jamwaffles/CNCMachine/IndramatResolver/PCB/20200531_093949688_iOS.jpg

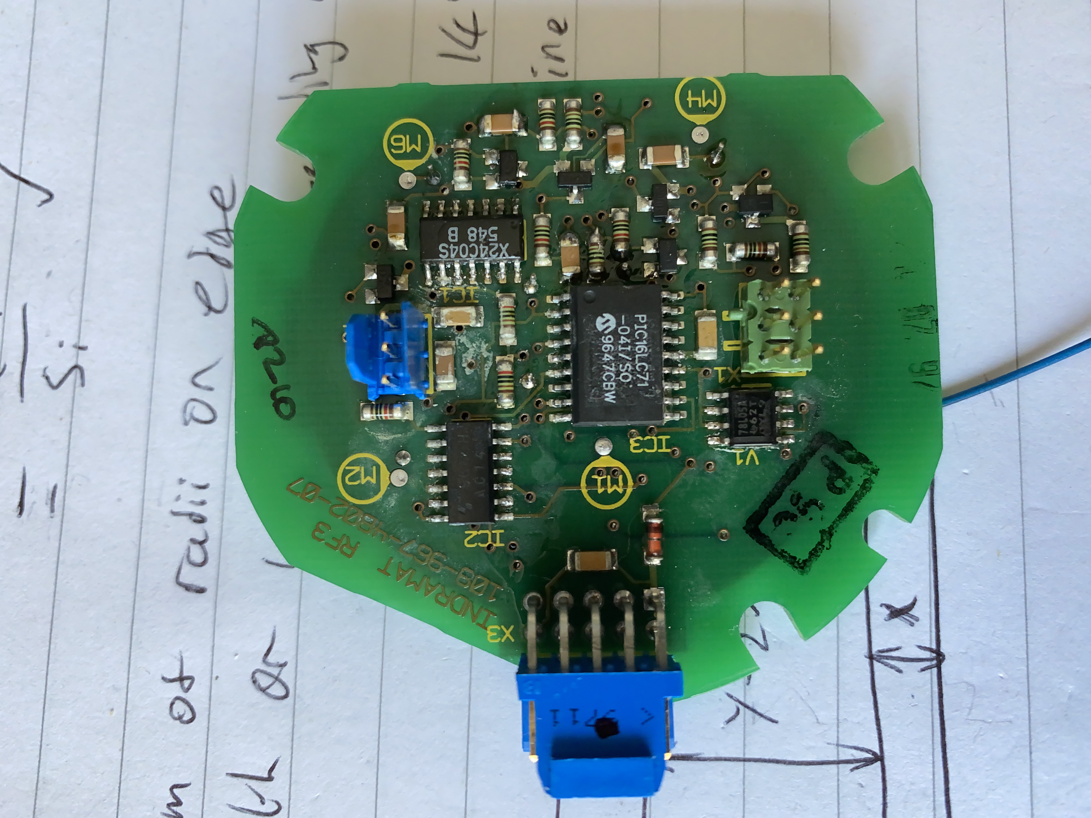
IndramatResolver/PCB/20200531_093949688_iOS.jpg
