jamwaffles/CNCMachine/tool-data/5mm Diameter Variable Helix Carbide End Mill for Aluminium DLC Coated 13mm Flute Associated Production Tools_files/EAV3S-3-FLUTE-CARBIDE-END-MILL-FOR-ALUMINIUM-DLC_002.jpg

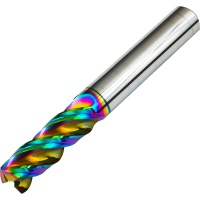
tool-data/5mm Diameter Variable Helix Carbide End Mill for Aluminium DLC Coated 13mm Flute Associated Production Tools_files/EAV3S-3-FLUTE-CARBIDE-END-MILL-FOR-ALUMINIUM-DLC_002.jpg
