jamwaffles/CNCMachine/control-box/README.md

# CNC control box

Feed rate override knobs and other buttons/switches.

Current setup uses the black version of the "Blue Pill" STM32F103 and a DAP-link compatible
programmer, although the STM32 Nucleo programmer works fine too.
