jamwaffles/CNCMachine/indramat-j-pulley-balance.md

8mm M4 grub as fillers, 2000 RPM initial

NO KEYWAY GRUB SCREW

| Grub screws | name/pos | Amax |
| --- | --- | --- |
| 0 | baseline | 0.15ms2 |
| 1 | pos 1 | 0.09ms2 |
| 1 | pos 2 | 0.15ms2 |
| 1 | pos 3 | 0.17ms2 |
| 1 | pos 1.5 | 0.11ms2 |
| 1 | pos 4.5 | 0.09ms2 |
| 2 | pos 1 | 0.05ms2 |
| 3 | pos 1 | 0.03ms2 |
| 4 | pos 1, pos 1 + 2, pos 1 - 2, pos 4 + 3 | unmeasured |

Pretty balanced at 5500. Slight resonance at 4000.
