jamwaffles/CNCMachine/freecad-tool-library/RECIPES.md

# Cut recipes for various tools

| N | Tool | Op | Material | WoC mm | DoC mm | RPM  | Feed |
| --- | --- | --- | --- | --- | --- | ---- | ---- |
| - | 22mm 3fl indexable endmill | Facing | Steel | 20 | 0.25 | 2200 | 900  |
| 5 | 6.3mm spot drill | Spot | Steel | - | - | 1500 | 100  |
| 10  | 6.5mm HSSCo drill | Drill  | Steel | - | - | 1700 | 80 |
