jamwaffles/CNCMachine/Allie/orientate12.01.2018_2018-01-13-3.pdf

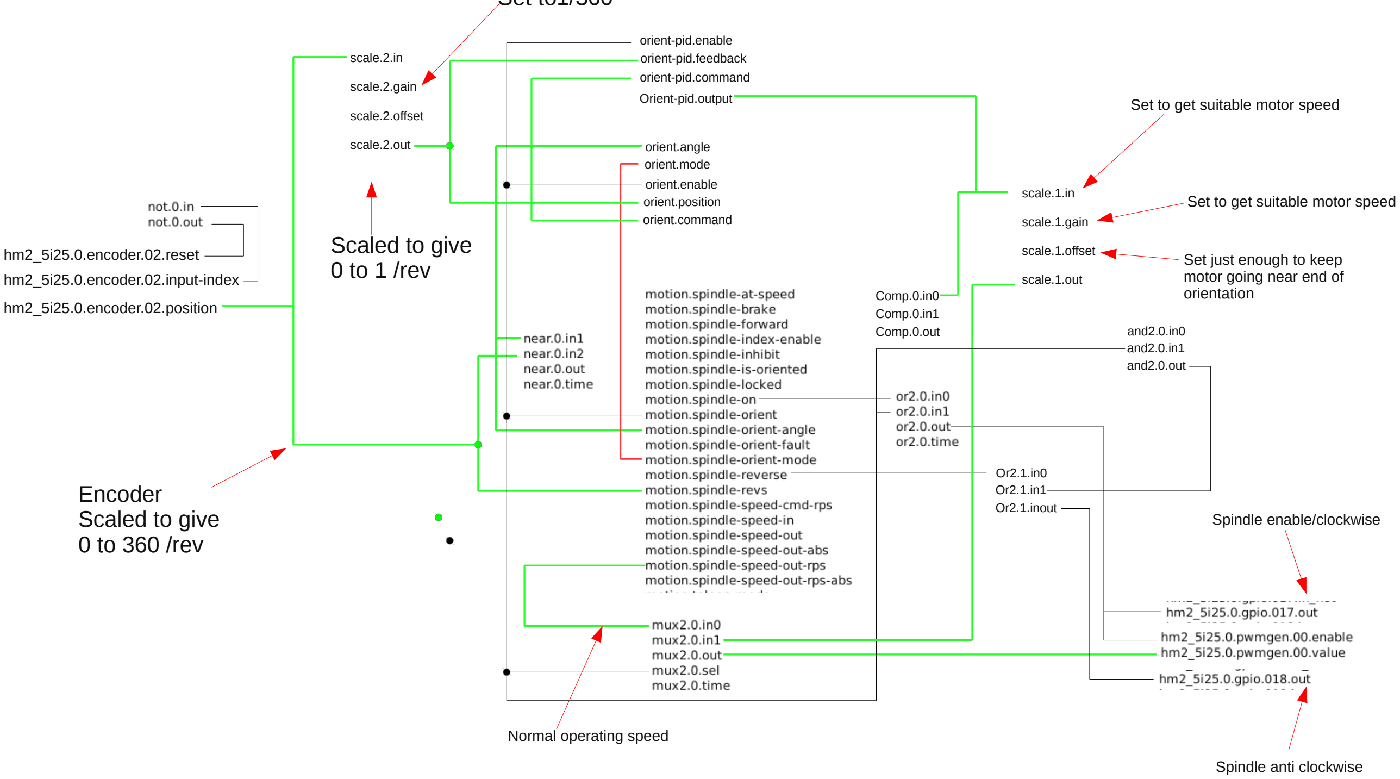
[picture p3: figure]
Spindle enable/clockwise; Normal operating speed; orient.angle orient.mode orient.enable orient.position orient.command; orient-pid.enable orient-pid.feedback orient-pid.command; Orient-pid.output; scale.2.in; scale.2.gain; scale.2.offset; scale.2.out; Set to get suitable motor speed; Set just enough to keep motor going near end of orientation; Or2.1.inout; Comp.0.in0 Comp.0.in1 Comp.0.out; and2.0.in1; and2.0.in0; and2.0.out; Scaled to give 0 to 1 /rev; Encoder Scaled to give 0 to 360 /rev; hm2_5i25.0.encoder.02.position; hm2_5i25.0.encoder.02.input-index; hm2_5i25.0.encoder.02.reset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

float

This set up will not work properly with Old Jaguar Cub inverter, as it will not go slow enough for spindle to stop near correct position. A newer drive may be ok. If the speed is set using the inverters own pot, the spindle will stop within two or three degrees. This would be fine for a 24/24 hole 'brake' disc/solenoid to lock spindle.

S32

## Set to1/360
