jamwaffles/CNCMachine/tool-data/5mm Diameter Carbide Drill 6mm Shank 26mm Flute Length 75mm Long AlTiN Coated Associated Production Tools_files/Carbide-Drill-AlTiN-Coated.jpg

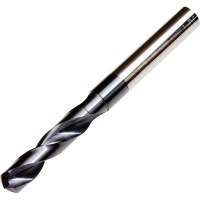
tool-data/5mm Diameter Carbide Drill 6mm Shank 26mm Flute Length 75mm Long AlTiN Coated Associated Production Tools_files/Carbide-Drill-AlTiN-Coated.jpg
