jamwaffles/CNCMachine/tool-data/Spiral Flute Chamfering Milling Cutter 6mm Diameter AlTiN Coated Carbide 90° Point 4 Flute Associated Production Tools_files/SFCT4-10100075-45-DEG-CARBIDE-CHAMFERING-CUTTER[1].jpg

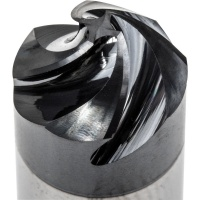
tool-data/Spiral Flute Chamfering Milling Cutter 6mm Diameter AlTiN Coated Carbide 90° Point 4 Flute Associated Production Tools_files/SFCT4-10100075-45-DEG-CARBIDE-CHAMFERING-CUTTER[1].jpg
