jamwaffles/CNCMachine/control-box-hardware/parts/5032_4P.STEP

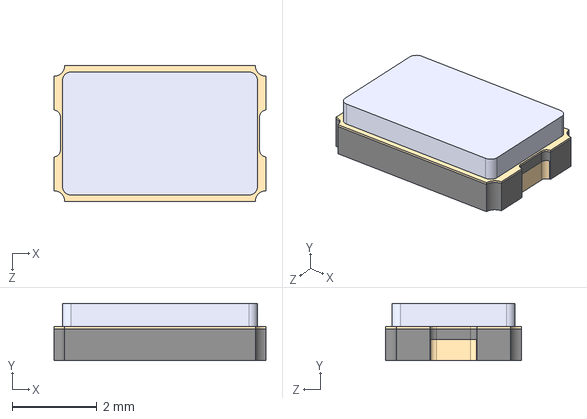
[picture p8: CAD file, 2024-06-03]
control-box-hardware/parts/5032_4P.STEP
5.00 x 1.35 x 3.20 mm
