jamwaffles/CNCMachine/control-box-hardware/parts/Bourns_Encoder_PEC11L-4115F-S0020/PEC11L-4115F-S0020/3D/PEC11L-4115F-S0020.stp

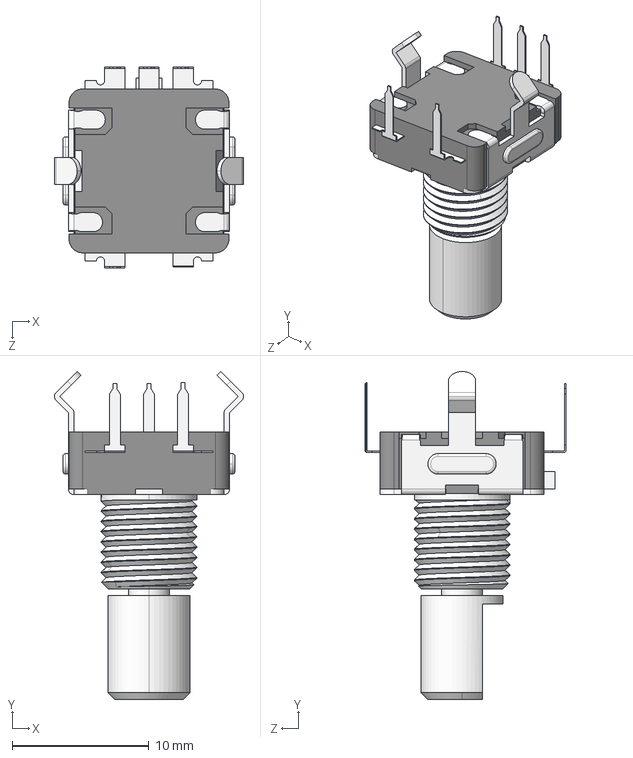
[picture p9: CAD file, 2024-06-03]
control-box-hardware/parts/Bourns_Encoder_PEC11L-4115F-S0020/PEC11L-4115F-S0020/3D/PEC11L-4115F-S0020.stp
13.8 x 24.0 x 14.7 mm
