jamwaffles/CNCMachine/control-box-hardware/parts/Button_TS-1187A-B-A-B/TS-1187A-B-A-B/3D/TS-1187A-B-A-B.stp

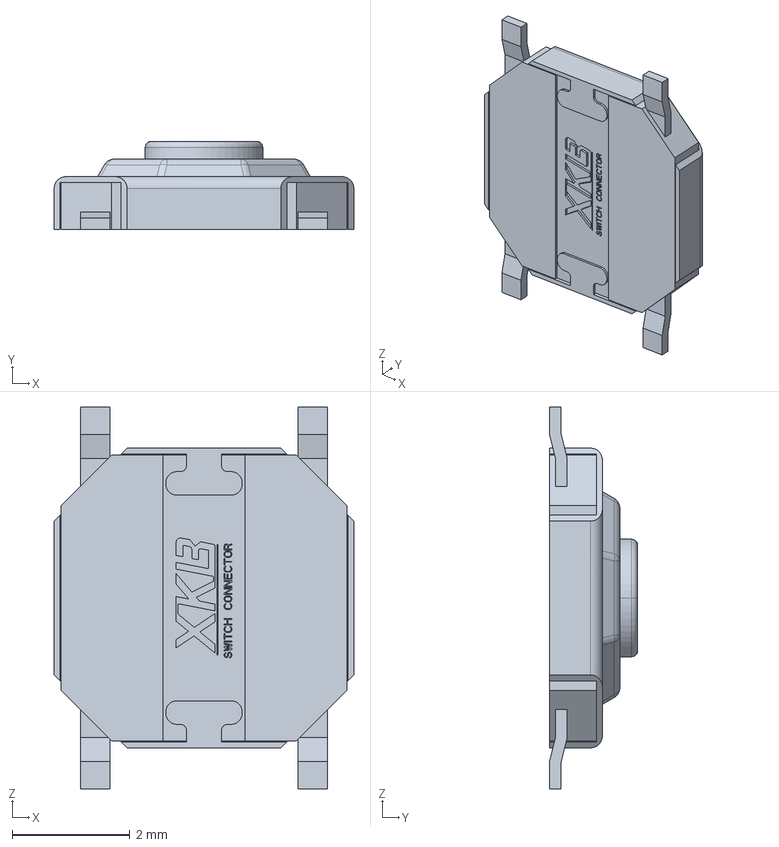
[picture p10: CAD file, 2024-06-03]
control-box-hardware/parts/Button_TS-1187A-B-A-B/TS-1187A-B-A-B/3D/TS-1187A-B-A-B.stp
5.10 x 1.50 x 6.50 mm
