jamwaffles/CNCMachine/freecad-tool-library/Shape/slittingsaw.fcstd

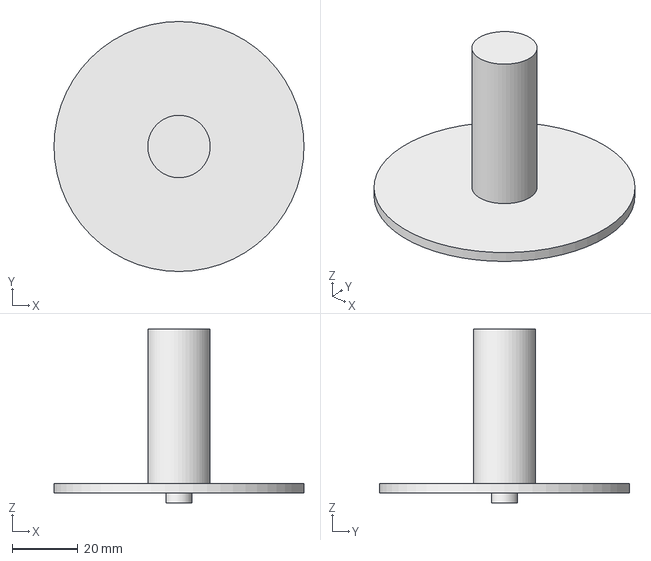
[picture p11: CAD file, 2023-11-02]
freecad-tool-library/Shape/slittingsaw.fcstd
76.2 x 76.2 x 53.0 mm
