jamwaffles/CNCMachine/UnifiedBreakout/UnifiedBreakout/Components/3D/NorComp-178-Dual-DB25.stp

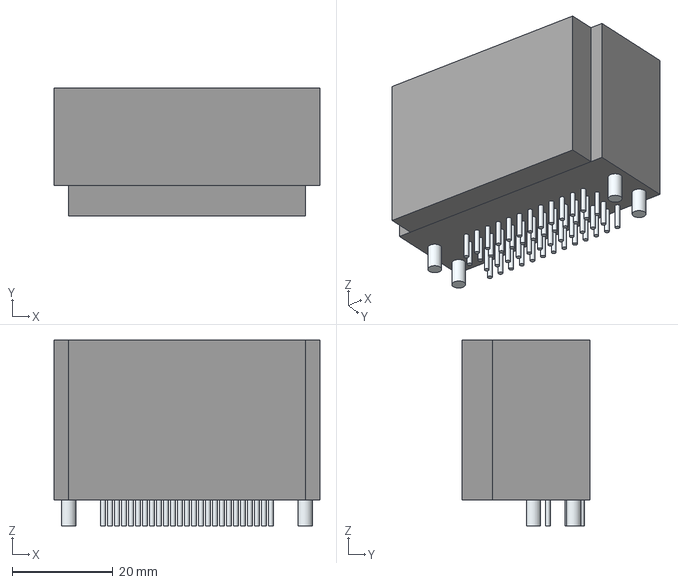
[picture p12: CAD file, 2023-03-16]
UnifiedBreakout/UnifiedBreakout/Components/3D/NorComp-178-Dual-DB25.stp
52.8 x 25.4 x 36.9 mm
Leads
