jamwaffles/CNCMachine/UnifiedBreakout/UnifiedBreakout/Components/SwitchCraft-BarrelJack-RAPC722BK/RAPC722BK.stp

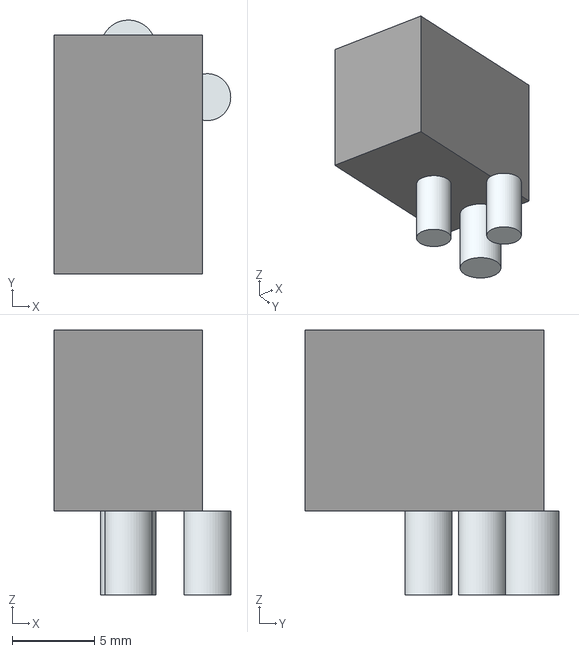
[picture p13: CAD file, 2020-04-14]
UnifiedBreakout/UnifiedBreakout/Components/SwitchCraft-BarrelJack-RAPC722BK/RAPC722BK.stp
10.7 x 15.4 x 16.1 mm
Leads x 3
