jamwaffles/CNCMachine/freecad-tool-library/Shape/probe.fcstd

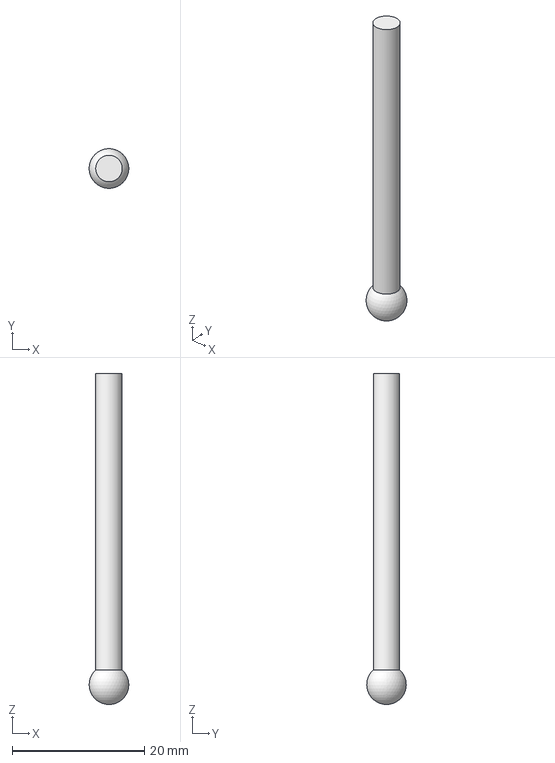
[picture p14: CAD file, 2023-11-02]
freecad-tool-library/Shape/probe.fcstd
5.99 x 5.98 x 50.0 mm
