jamwaffles/CNCMachine/UnifiedBreakout/UnifiedBreakout/Components/3D/NorComp-178-Dual-DA15.stp

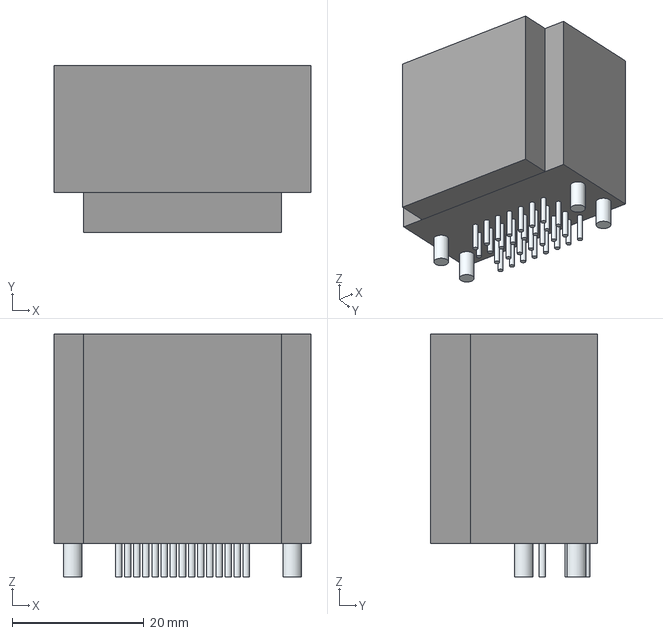
[picture p15: CAD file, 2023-03-16]
UnifiedBreakout/UnifiedBreakout/Components/3D/NorComp-178-Dual-DA15.stp
39.0 x 25.4 x 36.9 mm
Leads x 34
