jamwaffles/CNCMachine/freecad-tool-library/Shape/chamfer.fcstd

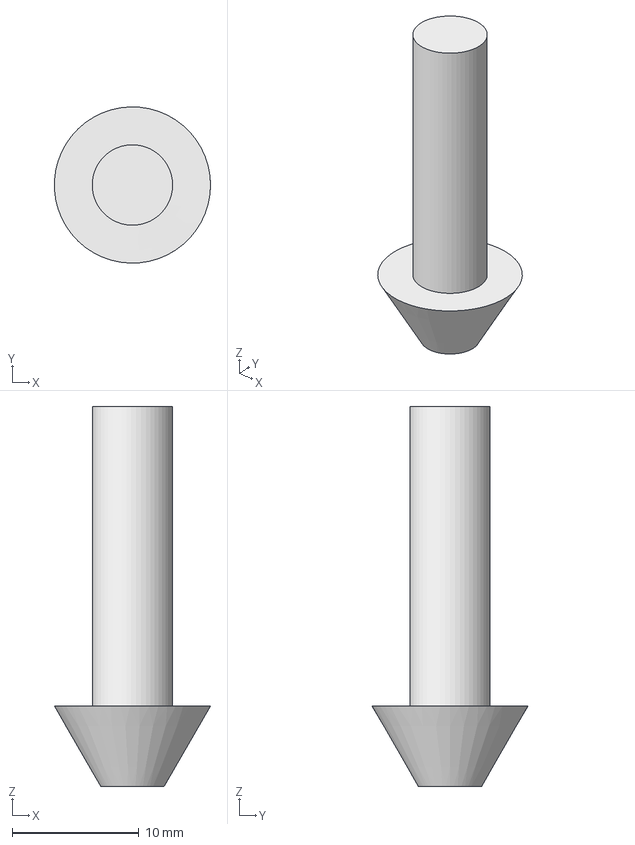
[picture p16: CAD file, 2023-11-02]
freecad-tool-library/Shape/chamfer.fcstd
12.3 x 12.3 x 30.0 mm
