jamwaffles/CNCMachine/freecad-tool-library/Shape/bullnose.fcstd

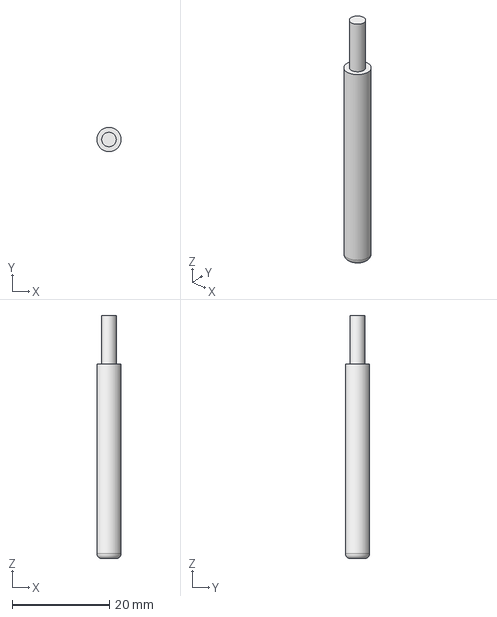
[picture p17: CAD file, 2023-11-02]
freecad-tool-library/Shape/bullnose.fcstd
5.00 x 5.00 x 50.0 mm
