jamwaffles/CNCMachine/freecad-tool-library/Shape/endmill.fcstd

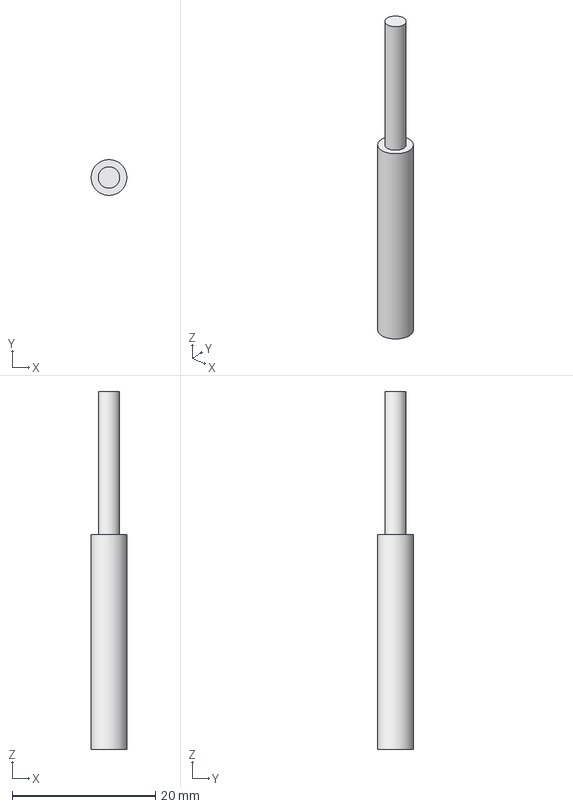
[picture p18: CAD file, 2023-11-02]
freecad-tool-library/Shape/endmill.fcstd
5.00 x 5.00 x 50.0 mm
