jamwaffles/CNCMachine/freecad-tool-library/Shape/spot-drill.fcstd

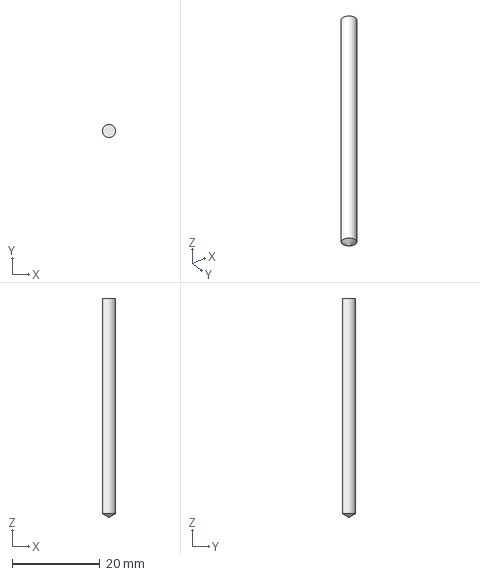
[picture p19: CAD file, 2023-11-02]
freecad-tool-library/Shape/spot-drill.fcstd
3.00 x 3.00 x 50.0 mm
