jamwaffles/CNCMachine/freecad-tool-library/Shape/thread-mill.fcstd

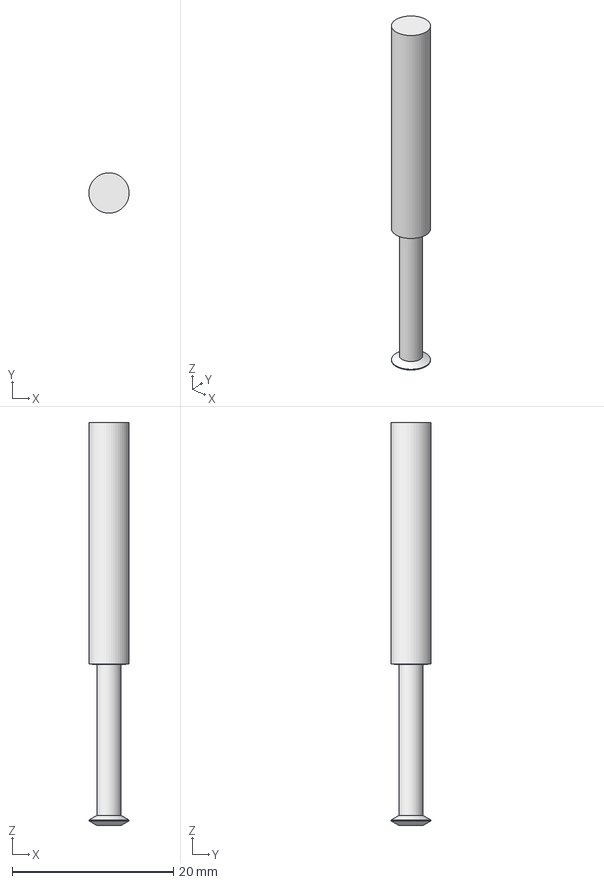
[picture p20: CAD file, 2023-11-02]
freecad-tool-library/Shape/thread-mill.fcstd
5.00 x 5.00 x 50.0 mm
