jamwaffles/CNCMachine/freecad-tool-library/Shape/v-bit.fcstd

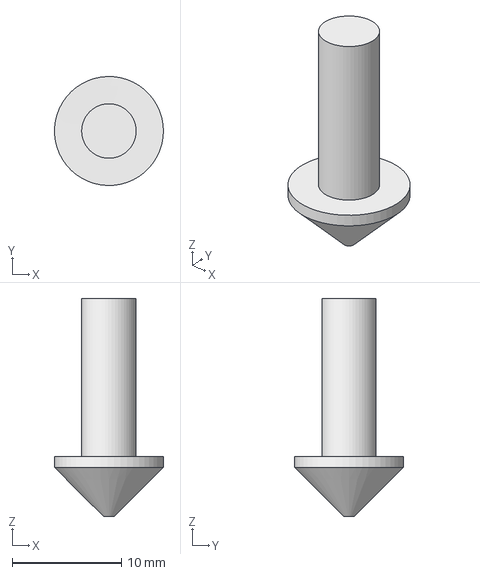
[picture p21: CAD file, 2023-11-02]
freecad-tool-library/Shape/v-bit.fcstd
9.99 x 10.00 x 20.0 mm
