jamwaffles/CNCMachine/freecad-tool-library/Shape/ballend.fcstd

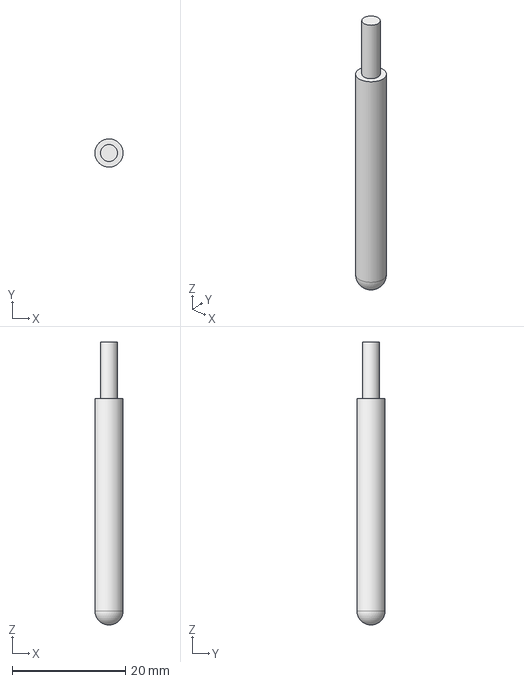
[picture p22: CAD file, 2023-11-02]
freecad-tool-library/Shape/ballend.fcstd
5.00 x 5.00 x 50.0 mm
