jamwaffles/CNCMachine/control-box-hardware/parts/Molex-67503-1020-mini-b/67503-1020/3D/67503-1020.stp

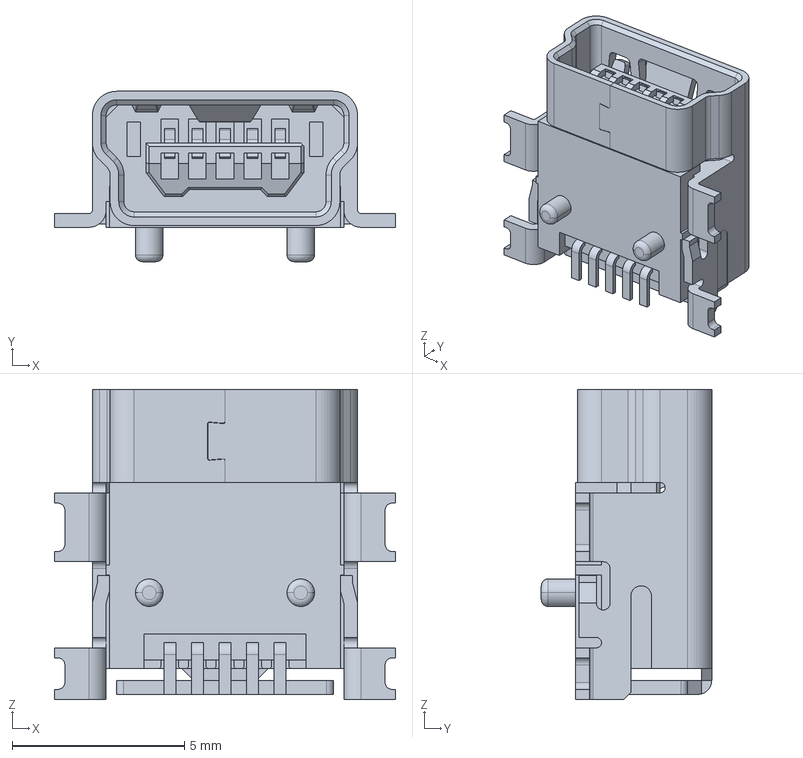
[picture p23: CAD file, 2024-06-03]
control-box-hardware/parts/Molex-67503-1020-mini-b/67503-1020/3D/67503-1020.stp
9.90 x 4.95 x 9.00 mm
