jamwaffles/CNCMachine/UnifiedBreakout/UnifiedBreakout/old_eagle_breakout/ATX_24pin.step

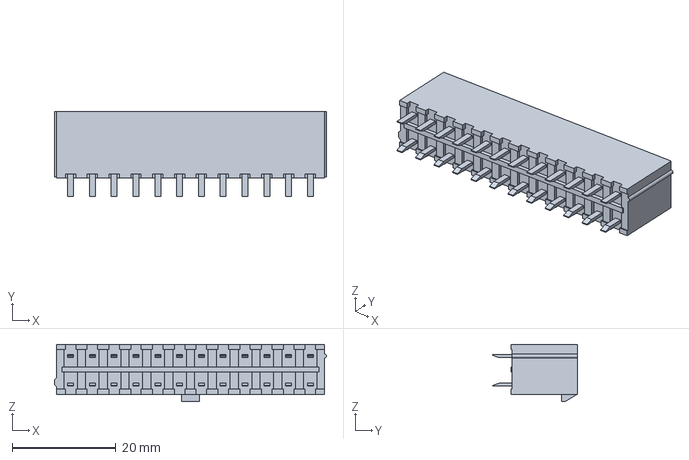
[picture p24: CAD file, 2020-03-08, an earlier design]
UnifiedBreakout/UnifiedBreakout/old_eagle_breakout/ATX_24pin.step
52.4 x 16.3 x 11.0 mm
