jamwaffles/CNCMachine/(list of files, cad)

Other CAD files:
freecad-tool-library/Shape/drill.fcstd
UnifiedBreakout/UnifiedBreakout/Components/SwitchCraft-BarrelJack-RAPC722BK/RAPC722BK.stl
control-box-hardware/parts/Bourns_Encoder_PEC11L-4115F-S0020/PEC11L-4115F-S0020/Allegro/pec11l4115fs0020.psm
control-box-hardware/parts/Bourns_Encoder_PEC11L-4115F-S0020/PEC11L-4115F-S0020/DEHDL/pec11l_4115f_s0020/chips/chips.prt
control-box-hardware/parts/Button_TS-1187A-B-A-B/TS-1187A-B-A-B/Allegro/ts1187abab.psm
control-box-hardware/parts/Button_TS-1187A-B-A-B/TS-1187A-B-A-B/DEHDL/ts_1187a_b_a_b/chips/chips.prt
control-box-hardware/parts/Molex-67503-1020-mini-b/67503-1020/Allegro/675031020.psm
control-box-hardware/parts/Molex-67503-1020-mini-b/67503-1020/DEHDL/67503_1020/chips/chips.prt
