jamwaffles/CNCMachine/probe-calibration.xlsx

X connector right | X connector left | Z connector left
140.310 | 140.275 | -366.472
140.310 | 140.289 | -366.472
140.306 | 140.276 | -366.472
140.307 | 140.277 | -366.473
140.311 | 140.276 | -366.471
140.315 | 140.275 | -366.472
140.321 | 140.279 | -366.472
140.311 | 140.278 | -366.472
L/R difference | 0.03
