jamwaffles/CNCMachine/control-box-hardware/cnc-interface-panel.kicad_pcb

## KiCad design control-box-hardware/cnc-interface-panel.kicad_pcb (2024-12-03)

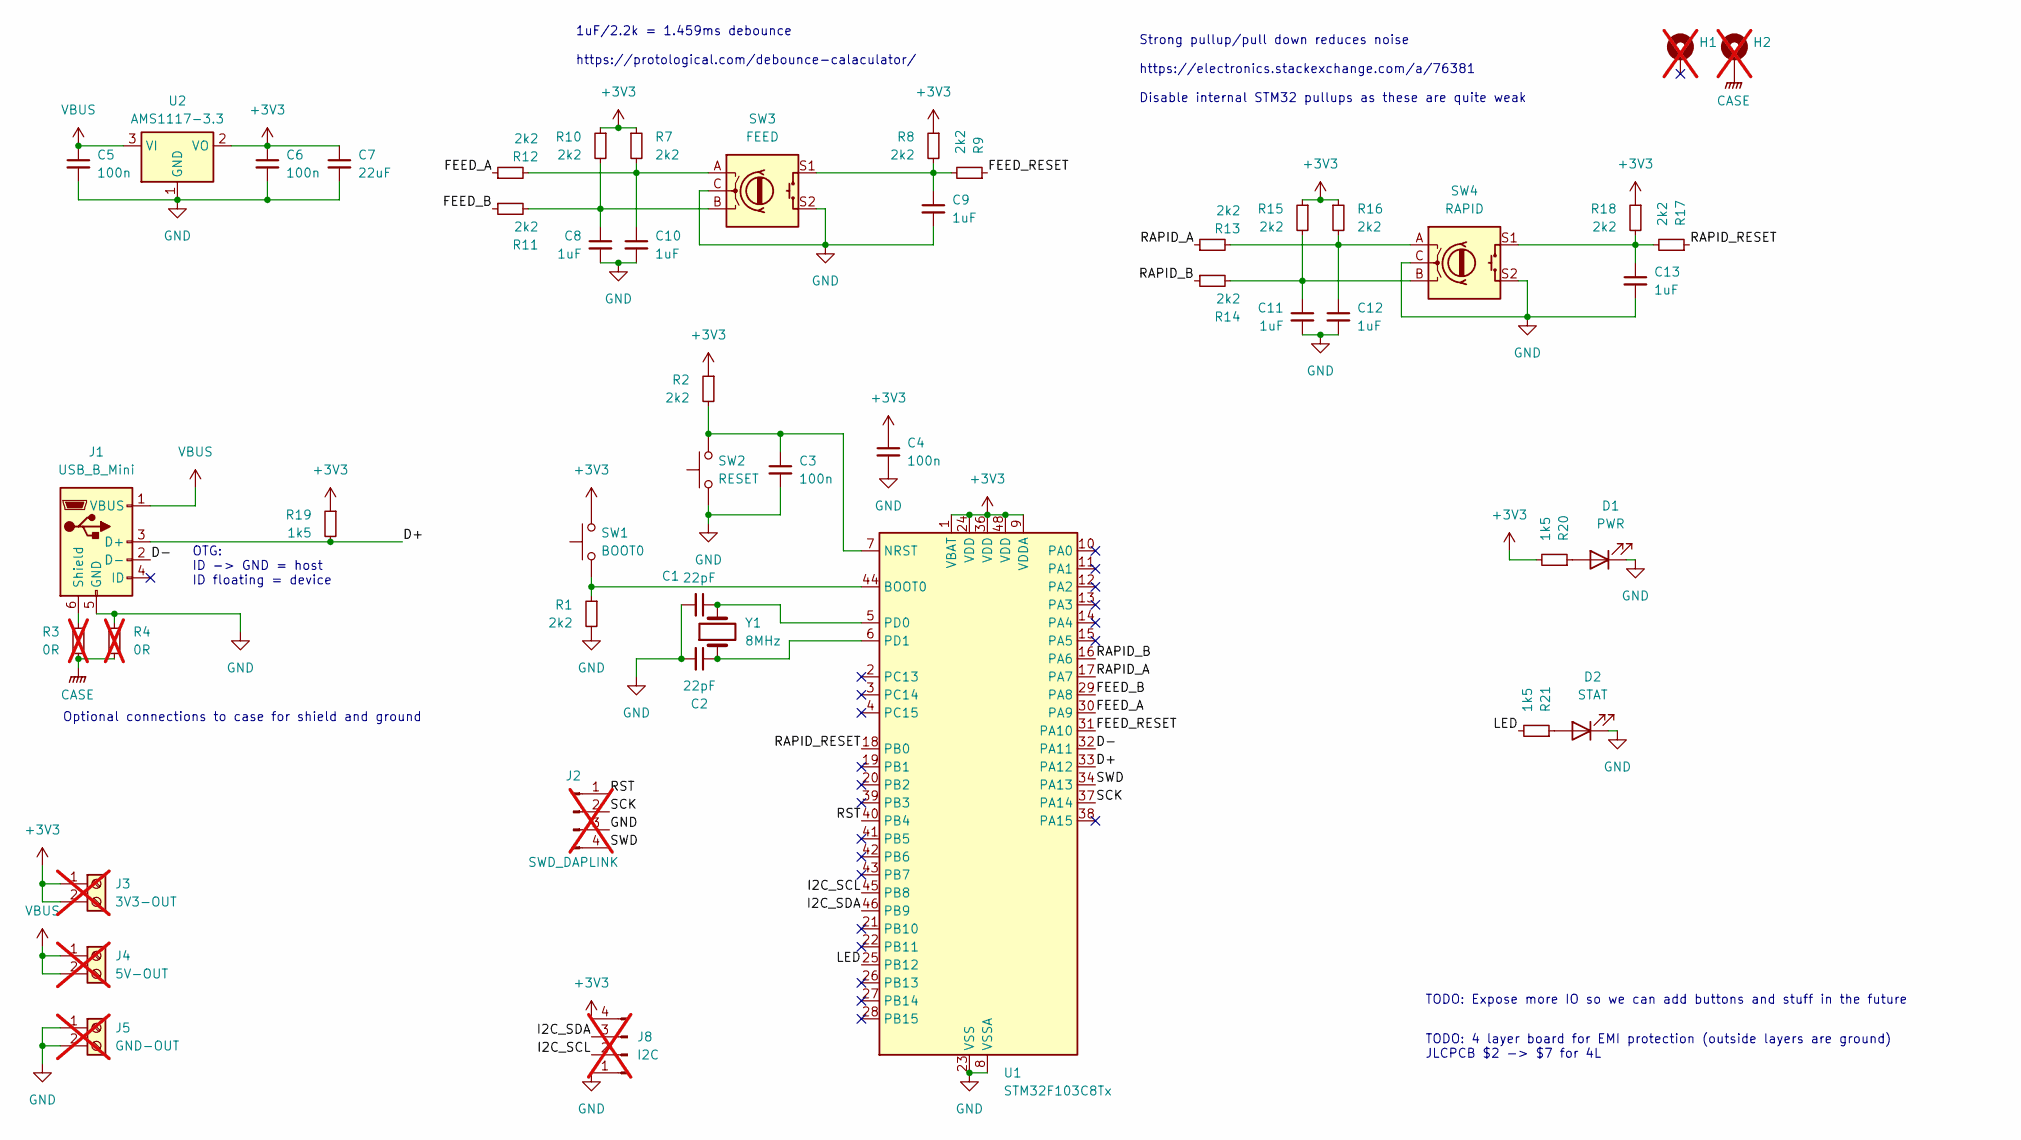
[picture p25: schematic cnc-interface-panel.kicad_sch]

Parts:
C1, C2: 22pF; C_0603_1608Metric_Pad1.08x0.95mm_HandSolder; MPN CL10C220JB8NNNC; JLCPCB C1653
C3, C4, C5, C6: 100n; C_0603_1608Metric_Pad1.08x0.95mm_HandSolder; MPN CC0603KRX7R9BB104; JLCPCB C14663
C7: 22uF; C_0603_1608Metric_Pad1.08x0.95mm_HandSolder; MPN CL10A226MQ8NRNC; JLCPCB C59461
C8, C9, C10, C11, C12, C13: 1uF; C_0603_1608Metric_Pad1.08x0.95mm_HandSolder; MPN CL10A105KB8NNNC; JLCPCB C15849
D1: PWR; LED_0603_1608Metric; MPN KT-0603W; JLCPCB C2290
D2: STAT; LED_0603_1608Metric; MPN KT-0603W; JLCPCB C2290
H1, H2: MountingHole_3.2mm_M3_Pad_Via; not fitted
J1: USB_B_Mini; molex-usb-mini-b-67503-1020; MPN 67503-1020; JLCPCB C136451
J2: SWD_DAPLINK; PinHeader_1x04_P2.54mm_Vertical; not fitted
J3: 3V3-OUT; TerminalBlock_Phoenix_MKDS-1,5-2_1x02_P5.00mm_Horizontal; not fitted
J4: 5V-OUT; TerminalBlock_Phoenix_MKDS-1,5-2_1x02_P5.00mm_Horizontal; not fitted
J5: GND-OUT; TerminalBlock_Phoenix_MKDS-1,5-2_1x02_P5.00mm_Horizontal; not fitted
J8: I2C; PinHeader_1x04_P2.54mm_Vertical; not fitted
R1, R2, R7, R8, R9, R10, R11, R12, R13, R14, R15, R16, R17, R18: 2k2; R_0603_1608Metric_Pad0.98x0.95mm_HandSolder; MPN 0603WAF2201T5E; JLCPCB C4190
R3, R4: 0R; R_0603_1608Metric_Pad0.98x0.95mm_HandSolder; MPN 0603WAF0000T5E; JLCPCB C21189; not fitted
R19, R20, R21: 1k5; R_0603_1608Metric_Pad0.98x0.95mm_HandSolder; MPN 0603WAF1501T5E; JLCPCB C22843
SW1: BOOT0; TS-1187A-B-A-B; MPN TS-1187A-B-A-B; JLCPCB C318884
SW2: RESET; TS-1187A-B-A-B; MPN TS-1187A-B-A-B; JLCPCB C318884
SW3: FEED; PEC11L4115FS0020; MPN PEC11L-4115F-S0020; JLCPCB C143799
SW4: RAPID; PEC11L4115FS0020; MPN PEC11L-4115F-S0020; JLCPCB C143799
U1: STM32F103C8Tx; LQFP-48_7x7mm_P0.5mm; MPN STM32F103C8T6; JLCPCB C8734
U2: AMS1117-3.3; SOT-223-3_TabPin2; MPN AMS1117-3.3; JLCPCB C6186
Y1: 8MHz; Crystal_SMD_TXC_7A-2Pin_5x3.2mm; MPN X50328MSB2GI; JLCPCB C115962

Connections:
+3V3: C4.1, C6.1, C7.1, J3.1, J3.2, J8.4, R2.1, R7.1, R8.1, R10.1, R15.1, R16.1, R18.1, R19.1, R20.2, SW1.2, U1.1 (VBAT), U1.9 (VDDA), U1.24 (VDD), U1.36 (VDD), U1.48 (VDD), U2.2 (VO)
/D+: J1.3 (D+), R19.2, U1.33 (PA12)
/D-: J1.2 (D-), U1.32 (PA11)
/FEED_A: R12.1, U1.30 (PA9)
/FEED_B: R11.1, U1.29 (PA8)
/FEED_RESET: R9.1, U1.31 (PA10)
/I2C_SCL: J8.2, U1.45 (PB8)
/I2C_SDA: J8.3, U1.46 (PB9)
/LED: R21.2, U1.25 (PB12)
/RAPID_A: R13.1, U1.17 (PA7)
/RAPID_B: R14.1, U1.16 (PA6)
/RAPID_RESET: R17.1, U1.18 (PB0)
/RST: J2.1, U1.40 (PB4)
/SCK: J2.2, U1.37 (PA14)
/SWD: J2.4, U1.34 (PA13)
CASE: H2.1, R3.2, R4.2
GND: C1.2, C2.2, C3.2, C4.2, C5.2, C6.2, C7.2, C8.2, C9.2, C10.2, C11.2, C12.2, C13.2, D1.1 (K), D2.1 (K), J1.5 (GND), J2.3, J5.1, J5.2, J8.1, R1.2, R4.1, SW2.1, SW3.C, SW3.S2, SW4.C, SW4.S2, U1.8 (VSSA), U1.23 (VSS), U1.35 (VSS), U1.47 (VSS), U2.1 (GND)
unnamed: C8.1, R10.2, R11.2, SW3.B
unnamed: C9.1, R8.2, R9.2, SW3.S1
unnamed: C10.1, R7.2, R12.2, SW3.A
unnamed: C11.1, R14.2, R15.2, SW4.B
unnamed: C12.1, R13.2, R16.2, SW4.A
unnamed: C13.1, R17.2, R18.2, SW4.S1
unnamed: D1.2 (A), R20.1
unnamed: D2.2 (A), R21.1
unnamed: J1.6 (Shield), R3.1
unnamed: R1.1, SW1.1, U1.44 (BOOT0)
unnamed: C3.1, R2.2, SW2.2, U1.7 (NRST)
unnamed: C1.1, U1.5 (PD0), Y1.2
unnamed: C2.1, U1.6 (PD1), Y1.1
VBUS: C5.1, J1.1 (VBUS), J4.1, J4.2, U2.3 (VI)

Notes on the sheet:
OTG: ID -> GND = host ID floating = device
Strong pullup/pull down reduces noise https://electronics.stackexchange.com/a/76381 Disable internal STM32 pullups as these are quite weak
Optional connections to case for shield and ground
TODO: 4 layer board for EMI protection (outside layers are ground) JLCPCB $2 -> $7 for 4L
1uF/2.2k = 1.459ms debounce https://protological.com/debounce-calaculator/
TODO: Expose more IO so we can add buttons and stuff in the future

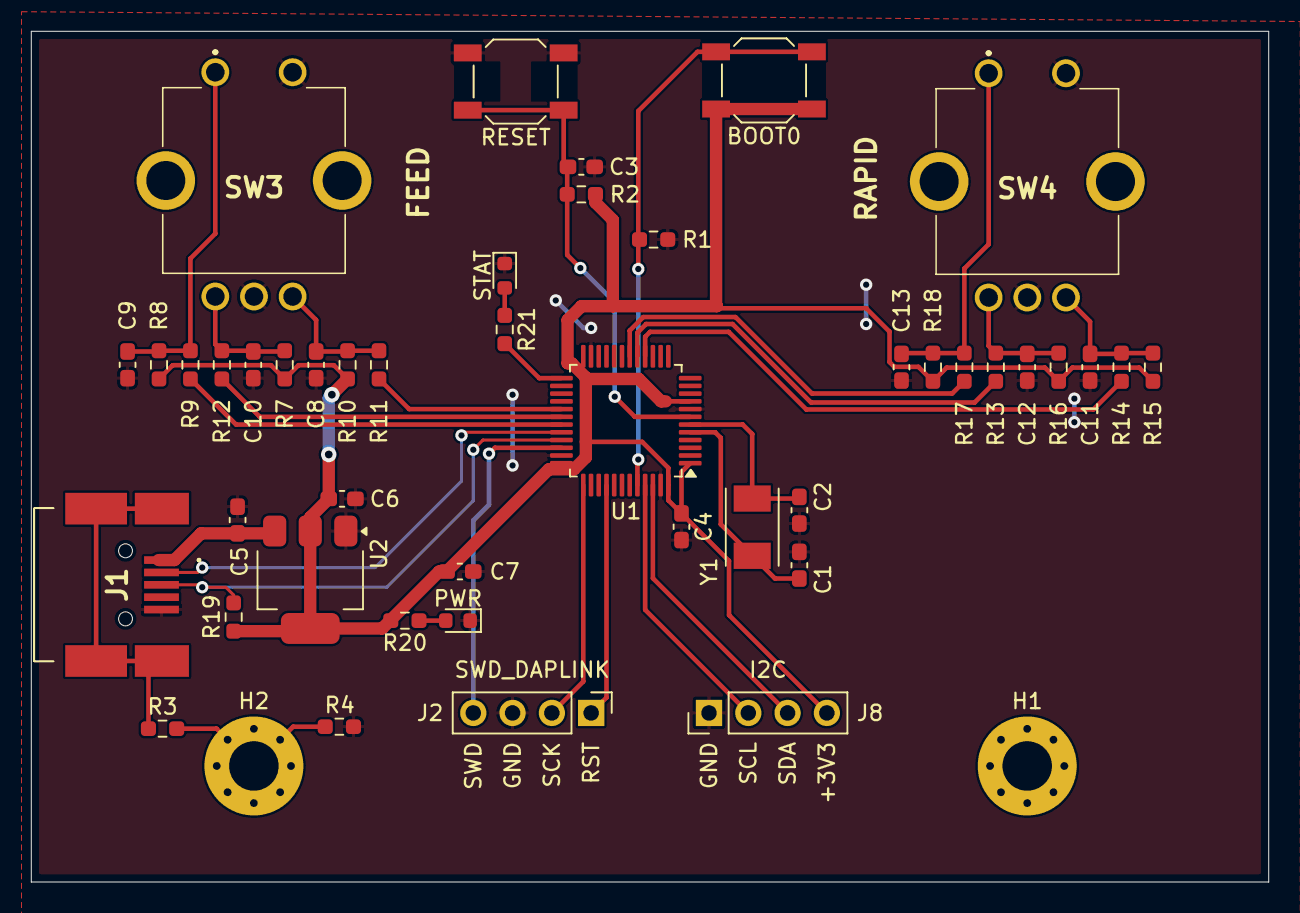
[picture p26: board cnc-interface-panel.kicad_pcb from above]

Board: 2 copper layers, 80.0 x 55.0 mm, 46 parts (0 on the bottom side), 31 nets.
