jamwaffles/CNCMachine/UnifiedBreakout/UnifiedBreakout/UnifiedBreakout.kicad_pcb

## KiCad design UnifiedBreakout/UnifiedBreakout/UnifiedBreakout.kicad_pcb (2023-04-08)

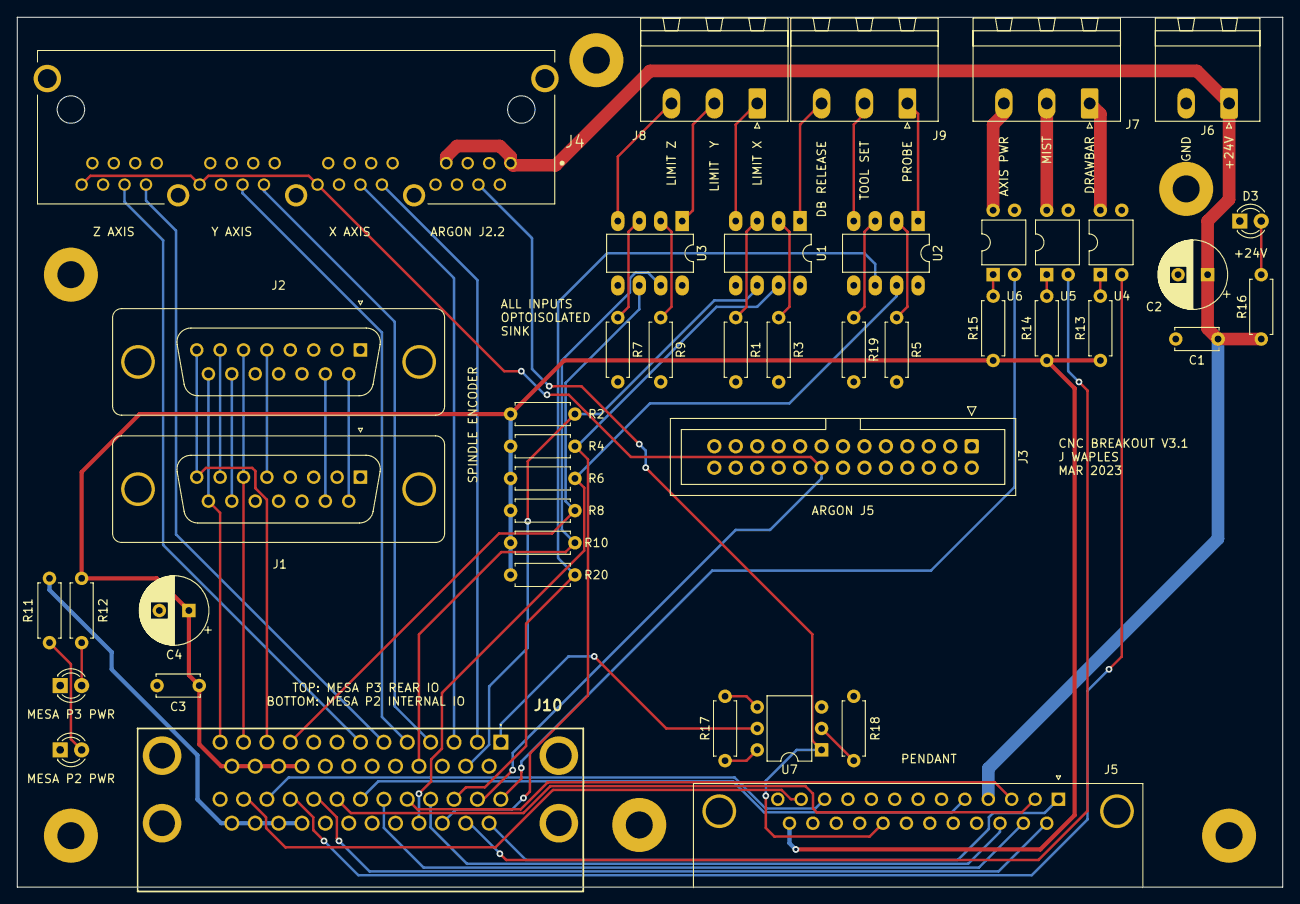
[picture p27: board UnifiedBreakout.kicad_pcb from above]

Board: 2 copper layers, 149.9 x 103.0 mm, 50 parts (0 on the bottom side), 61 nets.

Parts:
C1, C3: 100n; C_Disc_D5.0mm_W2.5mm_P5.00mm
C2, C4: 100uF; CP_Radial_D8.0mm_P3.50mm
D1: MESA P3 PWR; LED_D3.0mm
D2: MESA P2 PWR; LED_D3.0mm
D3: +24V; LED_D3.0mm
H1, H2, H3, H4, H5, H6: MountingHole; MountingHole_3.2mm_M3_Pad
J1, J2: DA15_Receptacle_MountingHoles; DSUB-15_Female_Vertical_P2.77x2.84mm_MountingHoles
J3: ARGON J5; IDC-Header_2x13_P2.54mm_Vertical
J4: SS71800-041F
J5: PENDANT; DSUB-25_Female_Horizontal_P2.77x2.84mm_EdgePinOffset7.70mm_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
J6: 24V BUS; PhoenixContact_MSTBA_2,5_2-G-5,08_1x02_P5.08mm_Horizontal
J7: DRAWBAR+MIST+AXIS_PWR; PhoenixContact_MSTBA_2,5_3-G-5,08_1x03_P5.08mm_Horizontal
J8: LIMIT; PhoenixContact_MSTBA_2,5_3-G-5,08_1x03_P5.08mm_Horizontal
J9: AUX; PhoenixContact_MSTBA_2,5_3-G-5,08_1x03_P5.08mm_Horizontal
J10: DB25_Receptacle_Dual; NorComp-Dual-DB25
R1, R3, R5, R7, R9, R16, R18, R19: 2K2; R_Axial_DIN0207_L6.3mm_D2.5mm_P7.62mm_Horizontal
R2, R4, R6, R8, R10, R20: 10K; R_Axial_DIN0207_L6.3mm_D2.5mm_P7.62mm_Horizontal
R11, R12: 220R; R_Axial_DIN0207_L6.3mm_D2.5mm_P7.62mm_Horizontal
R13, R14, R15: 680R; R_Axial_DIN0207_L6.3mm_D2.5mm_P7.62mm_Horizontal
R17: 220K; R_Axial_DIN0207_L6.3mm_D2.5mm_P7.62mm_Horizontal
U1, U2, U3: ILD74; DIP-8_W7.62mm_LongPads
U4, U5, U6: G3VM-61A1; DIP-4_W7.62mm
U7: 4N35; DIP-6_W7.62mm

Connections:
+5VP: C3.1, C4.1, J5.25, J10.A22, J10.A23, J10.A24, J10.A25, R2.1, R4.1, R6.1, R8.1, R10.1, R11.2, R13.1, R14.1, R15.1, R20.1
+24V: C1.1, C2.1, J4.1_1, J4.7_1, J5.4, J6.1, R16.2
/ALARM: J3.16, J4.8_2, J4.8_3, J4.8_4, J10.B2
/ARGON ENCODER/A-: J1.7, J2.7
/ARGON ENCODER/B-: J1.5, J2.5
/ARGON ENCODER/IDX-: J1.14, J2.14
/ARGON ESTOP/ESTOP+: J4.4_1, J5.21, U7.1
/AXIS_PWR: J10.B1, U6.2
/DRAWBAR SW/INPUT: J9.3, U1.1
/DRAWBAR_SW: J10.B16, R4.2, U1.7
/DRAWBAR_VALVE: J10.B10, U4.2
/ESTOP: J10.A1, U7.5
/LIM X/INPUT: J8.1, U1.4
/LIM Y/INPUT: J8.2, U3.1
/LIM Z/INPUT: J8.3, U3.4
/LIMIT_X: J10.A15, R2.2, U1.6
/LIMIT_Y: J10.A17, R10.2, U3.7
/LIMIT_Z: J10.A10, R8.2, U3.6
/MESA P2 INTERNAL IO/MESA_5V: J10.B22, J10.B23, J10.B24, J10.B25, R12.1
/MESA P3 REAR IO/IO_02_STEPGEN_00_STEP: J4.2_2, J10.A2
/MESA P3 REAR IO/IO_04_STEPGEN_00_DIR: J4.4_2, J10.A3
/MESA P3 REAR IO/IO_06_STEPGEN_01_STEP: J4.2_3, J10.A4
/MESA P3 REAR IO/IO_08_STEPGEN_01_DIR: J4.4_3, J10.A5
/MESA P3 REAR IO/IO_09_STEPGEN_02_STEP: J4.2_4, J10.A6
/MESA P3 REAR IO/IO_10_STEPGEN_02_DIR: J4.4_4, J10.A7
/MESA_P3_5V: D2.2 (A), R12.2
/MIST: J10.B15, U5.2
/PENDANT_ENC_A: J5.11, J10.B11
/PENDANT_ENC_B: J5.12, J10.B12
/PENDANT_MULX1: J5.15, J10.B6
/PENDANT_MULX10: J5.3, J10.B5
/PENDANT_MULX100: J5.16, J10.B4
/PENDANT_SELA: J5.5, J10.B7
/PENDANT_SELX: J5.1, J10.B14
/PENDANT_SELY: J5.14, J10.B9
/PENDANT_SELZ: J5.2, J10.B8
/PROBE: J10.B17, R6.2, U2.7
/PROBE/INPUT: J9.1, U2.1
/SPINDLE_ENC_A: J1.8, J2.8, J10.A11
/SPINDLE_ENC_B: J1.6, J2.6, J10.A12
/SPINDLE_ENC_IDX: J1.15, J2.15, J10.A13
/TOOL_PROBE: J10.B3, R20.2, U2.6
/TOOL_PROBE/INPUT: J9.2, U2.4
GND: C1.2, C2.2, C3.2, C4.2, D1.1 (K), D2.1 (K), D3.1 (K), J1.0 (PAD), J1.10, J2.0 (PAD), J2.10, J3.1, J3.15, J4.1_2, J4.1_3, J4.1_4, J4.3_2, J4.3_3, J4.3_4, J4.5_1, J4.5_2, J4.5_3, J4.5_4, J4.7_2, J4.7_3, J4.7_4, J4.8_1, J5.0 (PAD), J5.19, J5.20, J6.2, J10.A18, J10.A19, J10.A20, J10.A21, J10.B18, J10.B19, J10.B20, J10.B21, J10.MH1, J10.MH2, J10.MH3, J10.MH4, R1.2, R3.2, R5.2, R7.2, R9.2, R17.2, R18.2, R19.2, U1.5, U1.8, U2.5, U2.8, U3.5, U3.8, U4.3, U5.3, U6.3, U7.4
unnamed: D1.2 (A), R11.1
unnamed: D3.2 (A), R16.1
unnamed: J1.9, J2.9
unnamed: J7.1, U4.4
unnamed: J7.2, U5.4
unnamed: J7.3, U6.4
unnamed: R1.1, U1.3
unnamed: R3.1, U1.2
unnamed: R5.1, U2.2
unnamed: R7.1, U3.3
unnamed: R9.1, U3.2
unnamed: R13.2, U4.1
unnamed: R14.2, U5.1
unnamed: R15.2, U6.1
unnamed: R17.1, U7.6
unnamed: R18.1, U7.2
unnamed: R19.1, U2.3
