jamwaffles/CNCMachine/UnifiedBreakout/UnifiedBreakout/old_eagle_breakout/breakout.kicad_pcb

## KiCad design UnifiedBreakout/UnifiedBreakout/old_eagle_breakout/breakout.kicad_pcb (2020-03-08, an earlier design)

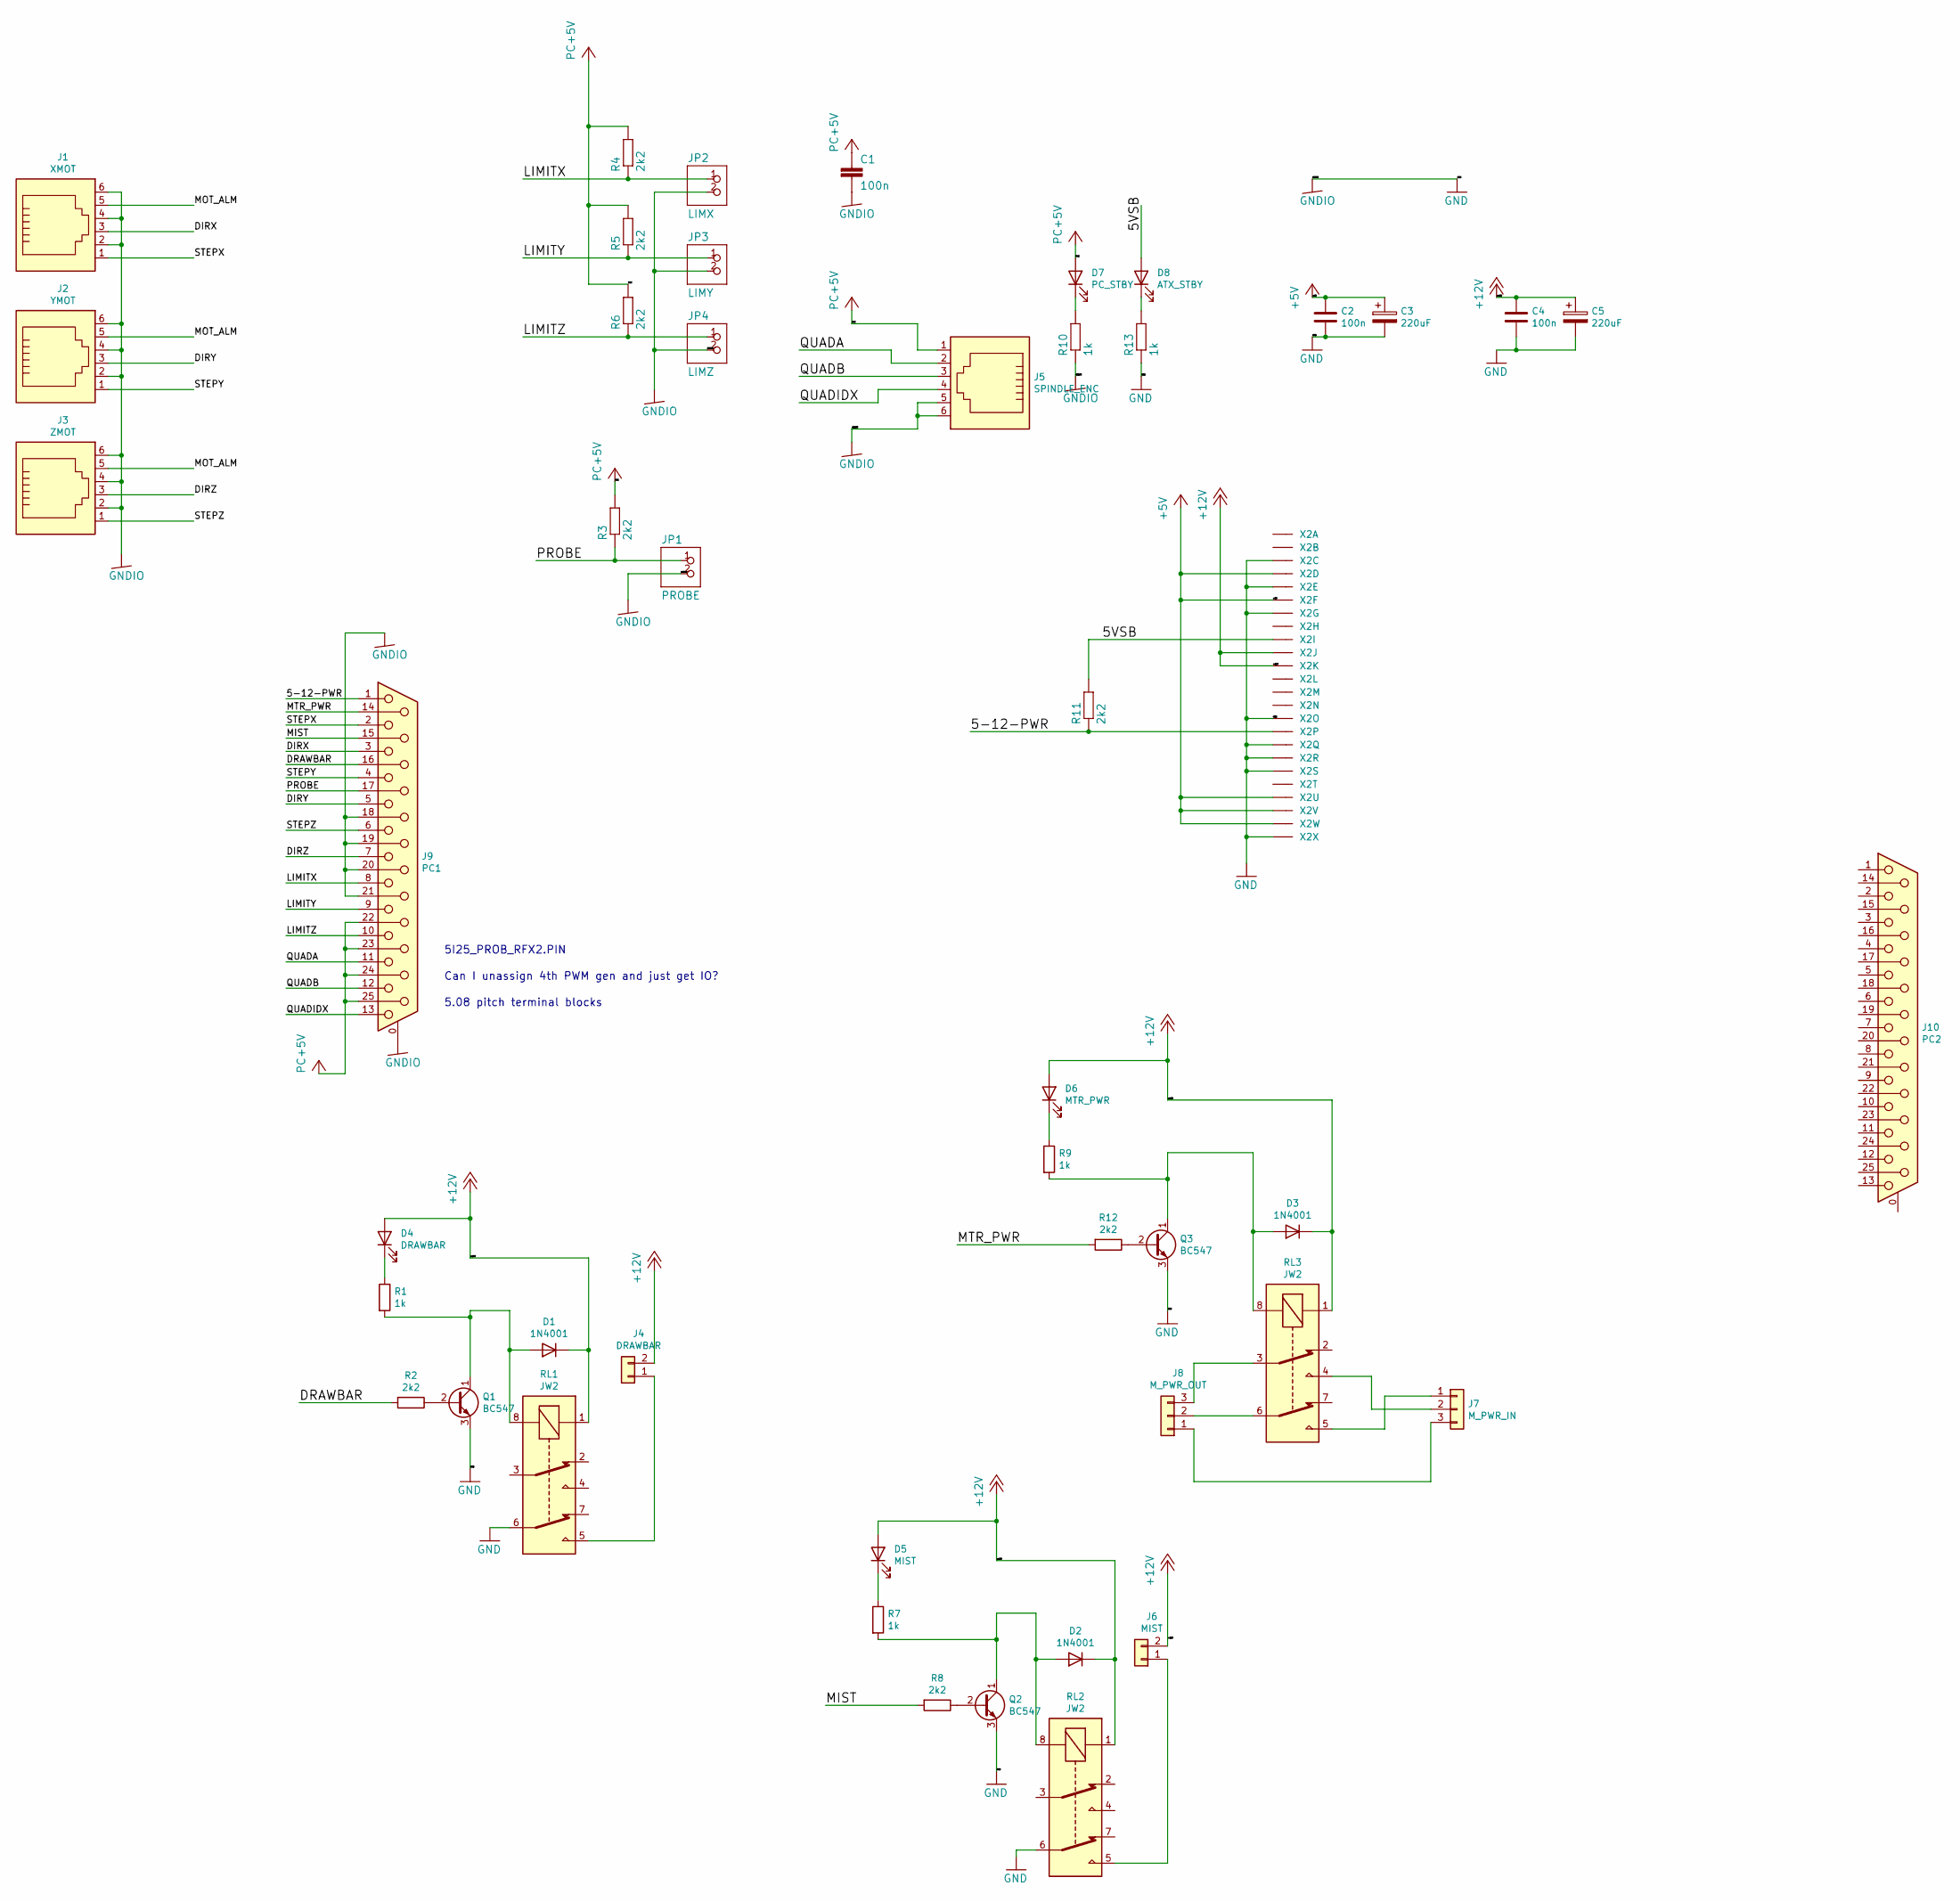
[picture p28: schematic breakout.sch]

Parts:
C1: 100n; C_Rect_L7.0mm_W2.5mm_P5.00mm
C2, C4: 100n; C_Disc_D8.0mm_W2.5mm_P5.00mm
C3, C5: 220uF; CP_Radial_D8.0mm_P3.80mm
D1, D2, D3: 1N4001; D_DO-41_SOD81_P10.16mm_Horizontal
D4: DRAWBAR; LED_D3.0mm
D5: MIST; LED_D3.0mm
D6: MTR_PWR; LED_D3.0mm
D7: PC_STBY; LED_D3.0mm
D8: ATX_STBY; LED_D3.0mm
J1: XMOT; 6p6c
J2: YMOT; 6p6c
J3: ZMOT; 6p6c
J4: DRAWBAR; kk156_26-60-4020
J5: SPINDLE_ENC; 6p6c
J6: MIST; kk156_26-60-4020
J7: M_PWR_IN; kk156_26-60-4030
J8: M_PWR_OUT; kk156_26-60-4030
J9: PC1; DB_25F
J10: PC2; DB_25F
JP1: PROBE; rca_yellow
JP2: LIMX; rca_black
JP3: LIMY; rca_black
JP4: LIMZ; rca_black
Q1, Q2, Q3: BC547; TO-92_Inline_Wide
R1, R7, R9, R10, R13: 1k; R_Axial_DIN0207_L6.3mm_D2.5mm_P7.62mm_Horizontal
R2, R3, R4, R5, R6, R8, R11, R12: 2k2; R_Axial_DIN0207_L6.3mm_D2.5mm_P7.62mm_Horizontal
RL1, RL2, RL3: JW2; Relay_DPDT_Panasonic_JW2
X2: 5566-24; Molex_Mini-Fit_Jr_5566-24A_2x12_P4.20mm_Vertical

Connections:
+5V: C2.1, C3.1, X2.4, X2.6, X2.21, X2.22, X2.23
+12V: C4.1, C5.1, D1.1 (K), D2.1 (K), D3.1 (K), D4.2 (A), D5.2 (A), D6.2 (A), J4.2, J6.2, RL1.1, RL2.1, RL3.1, X2.10, X2.11
/5-12-PWR: J9.1, R11.1, X2.16; also elsewhere on the board
/5VSB: D8.2 (A), R11.2, X2.9
/DIRX: J1.3, J9.3; also elsewhere on the board
/DIRY: J2.3, J9.5; also elsewhere on the board
/DIRZ: J3.3, J9.7; also elsewhere on the board
/DRAWBAR: J9.16, R2.2; also elsewhere on the board
/LIMITX: J9.8, JP2.1, R4.1; also elsewhere on the board
/LIMITY: J9.9, JP3.1, R5.1; also elsewhere on the board
/LIMITZ: J9.10, JP4.1, R6.1; also elsewhere on the board
/MIST: J9.15, R8.2; also elsewhere on the board
/MOT_ALM: J1.5, J2.5, J3.5
/MTR_PWR: J9.14, R12.2; also elsewhere on the board
/PROBE: J9.17, JP1.1, R3.1; also elsewhere on the board
/QUADA: J5.2, J9.11; also elsewhere on the board
/QUADB: J5.3, J9.12; also elsewhere on the board
/QUADIDX: J5.4, J9.13; also elsewhere on the board
/STEPX: J1.1, J9.2; also elsewhere on the board
/STEPY: J2.1, J9.4; also elsewhere on the board
/STEPZ: J3.1, J9.6; also elsewhere on the board
GND: C1.2, C2.2, C3.2, C4.2, C5.2, J1.2, J1.4, J1.6, J2.2, J2.4, J2.6, J3.2, J3.4, J3.6, J5.5, J5.6, J9.0 (PAD), J9.18, J9.19, J9.20, J9.21, JP1.2, JP2.2, JP3.2, JP4.2, Q1.3 (E), Q2.3 (E), Q3.3 (E), R10.1, R13.1, RL1.6, RL2.6, X2.3, X2.5, X2.7, X2.15, X2.17, X2.18, X2.19, X2.24; also elsewhere on the board
unnamed: D1.2 (A), Q1.1 (C), R1.2, RL1.8
unnamed: D2.2 (A), Q2.1 (C), R7.2, RL2.8
unnamed: D3.2 (A), Q3.1 (C), R9.2, RL3.8
unnamed: D4.1 (K), R1.1
unnamed: D5.1 (K), R7.1
unnamed: D6.1 (K), R9.1
unnamed: D7.1 (K), R10.2
unnamed: D8.1 (K), R13.2
unnamed: J4.1, RL1.5
unnamed: J6.1, RL2.5
unnamed: J7.1, RL3.5
unnamed: J7.2, RL3.4
unnamed: J7.3, J8.1
unnamed: J8.2, RL3.6
unnamed: J8.3, RL3.3
unnamed: Q1.2 (B), R2.1
unnamed: Q2.2 (B), R8.1
unnamed: Q3.2 (B), R12.1
VCC: C1.1, D7.2 (A), J5.1, J9.22, J9.23, J9.24, J9.25, R3.2, R4.2, R5.2, R6.2; also elsewhere on the board

Notes on the sheet:
5I25_PROB_RFX2.PIN
5.08 pitch terminal blocks
Can I unassign 4th PWM gen and just get IO?

Board: 2 copper layers, 48 parts (0 on the bottom side), 41 nets, no tracks yet.

Other parts of the board:
X1: PC; DB_25F

Their connections:
/5-12-PWR: X1.1; also elsewhere on the board
/DIRX: X1.3; also elsewhere on the board
/DIRY: X1.5; also elsewhere on the board
/DIRZ: X1.7; also elsewhere on the board
/DRAWBAR: X1.16; also elsewhere on the board
/LIMITX: X1.8; also elsewhere on the board
/LIMITY: X1.9; also elsewhere on the board
/LIMITZ: X1.10; also elsewhere on the board
/MIST: X1.15; also elsewhere on the board
/MTR_PWR: X1.14; also elsewhere on the board
/PROBE: X1.17; also elsewhere on the board
/QUADA: X1.11; also elsewhere on the board
/QUADB: X1.12; also elsewhere on the board
/QUADIDX: X1.13; also elsewhere on the board
/STEPX: X1.2; also elsewhere on the board
/STEPY: X1.4; also elsewhere on the board
/STEPZ: X1.6; also elsewhere on the board
GND: X1.18, X1.19, X1.20, X1.21; also elsewhere on the board
VCC: X1.22, X1.23, X1.24, X1.25; also elsewhere on the board
