jamwaffles/CNCMachine/Allie/Allie.ini

# This config file was created 2016-07-23 11:12:37.119737 by the update_ini script
# The original config files may be found in the /home/emc/linuxcnc/configs/Allie/Allie.old directory

# Generated by PNCconf at Sun Jan 24 10:38:23 2016
# If you make changes to this file, they will be
# overwritten when you run PNCconf again

[EMC]
# The version string for this INI file.
VERSION = 1.1

RUN_IN_PLACE=no

MACHINE = Allie
# DEBUG = 0x00000092

[DISPLAY]
DISPLAY = axis
POSITION_OFFSET = RELATIVE
POSITION_FEEDBACK = ACTUAL
MAX_FEED_OVERRIDE = 2.0
MAX_SPINDLE_OVERRIDE = 2.000000
MIN_SPINDLE_OVERRIDE = 0.500000
INTRO_GRAPHIC = linuxcnc.gif
INTRO_TIME = 1
PROGRAM_PREFIX = /home/linuxcnc/GCode
INCREMENTS = 5mm 1mm .5mm .1mm .05mm .01mm .005mm
POSITION_FEEDBACK = COMMANDED
DEFAULT_LINEAR_VELOCITY = 20
MAX_LINEAR_VELOCITY = 200.0
MIN_LINEAR_VELOCITY = 0
DEFAULT_ANGULAR_VELOCITY = 0.250000
MAX_ANGULAR_VELOCITY = 1.000000
MIN_ANGULAR_VELOCITY = 0.010000
EDITOR = gedit
GEOMETRY = xyz
TOOL_EDITOR = tooledit DIAM Z COMMENT
PYVCP = custompanel.xml

[FILTER]
PROGRAM_EXTENSION = .png,.gif,.jpg Greyscale Depth Image
PROGRAM_EXTENSION = .py Python Script
png = image-to-gcode
gif = image-to-gcode
jpg = image-to-gcode
py = python

[RS274NGC]
# Subroutine paths, separated by colons
SUBROUTINE_PATH = ~/Repositories/CNCMachine/Allie/subs

PARAMETER_FILE = linuxcnc.var
# REMAP=M6 modalgroup=6 prolog=change_prolog ngc=change epilog=change_epilog
REMAP=M6 modalgroup=6 ngc=change

[EMCMOT]
EMCMOT = motmod
COMM_TIMEOUT = 1.0
COMM_WAIT = 0.010
SERVO_PERIOD = 500000

[TASK]
TASK = milltask
CYCLE_TIME = 0.010

[HAL]
HALUI = halui
HALFILE = Allie.hal
HALFILE = spindle.hal
HALFILE = mpg.hal
# FIXME: Uncomment! This is commented out because the probe input(s) keep tripping
# HALFILE = probe.hal
POSTGUI_HALFILE = custompanel.hal
# SHUTDOWN = shutdown.hal

[HALUI]
[TRAJ]

AXES = 3
COORDINATES = X Y Z
LINEAR_UNITS = mm
ANGULAR_UNITS = degree
CYCLE_TIME = 0.010
DEFAULT_LINEAR_VELOCITY = 9.50
MAX_LINEAR_VELOCITY = 75.00
NO_FORCE_HOMING = 1

[EMCIO]
EMCIO = io
CYCLE_TIME = 0.100
TOOL_TABLE = tool.tbl
TOOL_CHANGE_QUILL_UP = 1

#********************
# Axis X
# SFU1610 ballscrew
#********************

[KINS]
KINEMATICS = trivkins
#This is a best-guess at the number of joints, it should be checked
JOINTS = 3

[AXIS_X]
MIN_LIMIT = 0
MAX_LIMIT = 380.0
MAX_VELOCITY = 125.0
MAX_ACCELERATION = 500.00

[JOINT_0]

TYPE = LINEAR
HOME = 5.0
FERROR = 1.0
MIN_FERROR = 1.0
MAX_VELOCITY = 125.0
MAX_ACCELERATION = 500.00
# The values below should be 25% larger than MAX_VELOCITY and MAX_ACCELERATION
# If using BACKLASH compensation STEPGEN_MAXACCEL should be 100% larger.
STEPGEN_MAXVEL = 250
STEPGEN_MAXACCEL = 3000
# https://forum.linuxcnc.org/38-general-linuxcnc-questions/31046-open-loop-stepper-pid#75547
P = 1000.0
I = 0.0
D = 0.0
FF0 = 0.0
FF1 = 1.0
FF2 = 0.0
BIAS = 0.0
DEADBAND = 0.0
MAX_OUTPUT = 0.0
# these are in nanoseconds
DIRSETUP   = 5000
DIRHOLD    = 10000
STEPLEN    = 2500
STEPSPACE  = 2500
STEP_SCALE = 200
MIN_LIMIT = -.2
MAX_LIMIT = 380.0
HOME_OFFSET = 0.000000
HOME_SEARCH_VEL = -40.000000
HOME_LATCH_VEL = 3.0
HOME_FINAL_VEL = 50.000000
HOME_USE_INDEX = NO
HOME_IGNORE_LIMITS = YES
HOME_SEQUENCE = 1
VOLATILE_HOME = 1
BACKLASH = 0.0

#********************
# Axis Y
# SFU1610 ballscrew
#********************
[AXIS_Y]
MIN_LIMIT = 0
MAX_LIMIT = 345.0
MAX_VELOCITY = 125.0
MAX_ACCELERATION = 1000.00

[JOINT_1]

TYPE = LINEAR
HOME = 335.0
FERROR = 1.0
MIN_FERROR = 1.0
MAX_VELOCITY = 125.0
MAX_ACCELERATION = 1000.00
# The values below should be 25% larger than MAX_VELOCITY and MAX_ACCELERATION
# If using BACKLASH compensation STEPGEN_MAXACCEL should be 100% larger.
STEPGEN_MAXVEL = 250
STEPGEN_MAXACCEL = 3000
# https://forum.linuxcnc.org/38-general-linuxcnc-questions/31046-open-loop-stepper-pid#75547
P = 1000.0
I = 0.0
D = 0.0
FF0 = 0.0
FF1 = 1.0
FF2 = 0.0
BIAS = 0.0
DEADBAND = 0.0
MAX_OUTPUT = 0.0
# these are in nanoseconds
DIRSETUP   = 5000
DIRHOLD    = 10000
STEPLEN    = 2500
STEPSPACE  = 2500

# HBS 507 configured for 2000 pulse/rev
STEP_SCALE = 200
MIN_LIMIT = -.2
MAX_LIMIT = 345.0
HOME_OFFSET = 345.000000
HOME_SEARCH_VEL = 40.000000
HOME_LATCH_VEL = -3.0
HOME_FINAL_VEL = 50.000000
HOME_USE_INDEX = NO
HOME_IGNORE_LIMITS = YES
HOME_SEQUENCE = 1
VOLATILE_HOME = 1
BACKLASH = 0.0

#********************
# Axis Z
# SFU2010 ballscrew
#********************
[AXIS_Z]
MIN_LIMIT = -590.0
MAX_LIMIT = 1.0
MAX_VELOCITY = 95.0
MAX_ACCELERATION = 700.0

[JOINT_2]

TYPE = LINEAR
HOME = 0.0
FERROR = 2.0
MIN_FERROR = 2.0
MAX_VELOCITY = 95.0
MAX_ACCELERATION = 400.0
# The values below should be 25% larger than MAX_VELOCITY and MAX_ACCELERATION
# If using BACKLASH compensation STEPGEN_MAXACCEL should be 100% larger.
STEPGEN_MAXVEL = 150.0
STEPGEN_MAXACCEL = 1500.0
# https://forum.linuxcnc.org/38-general-linuxcnc-questions/31046-open-loop-stepper-pid#75547
P = 1000.0
I = 0.0
D = 0.0
FF0 = 0.0
FF1 = 1.0
FF2 = 0.0
BIAS = 0.0
DEADBAND = 0.0
MAX_OUTPUT = 0.0
# these are in nanoseconds
DIRSETUP   = 5000
DIRHOLD    = 10000
STEPLEN    = 2500
STEPSPACE  = 2500
STEP_SCALE = 200
MIN_LIMIT = -590.0
MAX_LIMIT = 1.0
HOME_OFFSET = 0.000000
HOME_SEARCH_VEL = 40.000000
HOME_LATCH_VEL = -2.0
HOME_FINAL_VEL = 40.000000
HOME_USE_INDEX = NO
HOME_IGNORE_LIMITS = YES
HOME_SEQUENCE = 0
VOLATILE_HOME = 1
# BACKLASH = 0.035
BACKLASH = 0.0

#********************
# Spindle
#********************
[HOSTMOT2]
# **** This is for info only ****
# DRIVER0=hm2_pci
# BOARD0=5i25

[SPINDLE_9]
# MAX_VELOCITY = 100.0
# MAX_ACCELERATION = 100.0
# # The values below should be 25% larger than MAX_VELOCITY and MAX_ACCELERATION
# # If using BACKLASH compensation STEPGEN_MAXACCEL should be 100% larger.
# STEPGEN_MAXVEL = 125.00
# STEPGEN_MAXACCEL = 125.00
#
# # VEL_P = 0.0
# # VEL_I = 0.0
# # VEL_D = 0.0
# # VEL_FF0 = 1.0
# # VEL_FF1 = 0.0
# # VEL_FF2 = 0.0
# # VEL_BIAS = 0.0
# # VEL_DEADBAND = 0.0
#
# POS_P = 50.0
# POS_I = 0.0
# POS_D = 0.0
# POS_FF0 = 0.0
# POS_FF1 = 1.0
# POS_FF2 = 0.0
# POS_BIAS = 0.0
# POS_DEADBAND = 0.0
#
# MAX_OUTPUT = 410000.0
ENCODER_SCALE = -4096.0
# # these are in nanoseconds
# DIRSETUP   = 1000
# DIRHOLD    = 1000
# STEPLEN    = 1000
# STEPSPACE  = 1000
# STEP_SCALE = 2048.0
