jamwaffles/CNCMachine/EtherCAT/custompanel.hal

net spindle-fb-rpm-filtered => pyvcp.spindle-speed-rpm
net spindle-at-speed => pyvcp.spindle-at-speed
net orient-enable => pyvcp.orient-enable
net is-oriented => pyvcp.is-oriented
net spindle-drive-error => pyvcp.drive-error
net toolsetter => pyvcp.toolsetter
net touch-probe => pyvcp.touch-probe
net all-op => lcec.all-op pyvcp.ecat-all-op
net ring-light-on => pyvcp.ring-light-on
