jamwaffles/CNCMachine/(commit log)

2016-02-10 Config from archive 2015-12-10
    [Allie.hal, custom.hal, custom_postgui.hal, postgui_backup.hal]
2016-02-10 Config from archive 2016-01-05
    [custom.hal, custom_postgui.hal]
2016-02-10 Config from archive 2016-01-24 (5i25)
    [Allie.hal, custom_gvcp.hal, postgui_backup.hal, postgui_call_list.hal, shutdown.hal]
2016-02-10 Config from archive 2016-02-02 (5i25)
    [Allie.hal]
2016-03-12 Slower rapids for X and Y
    Tightened bearings, 150mm/sec would stall
    [Allie.ini]
2016-03-12 Correct scale for Z axis
    4mm pitch leadscrew, 32 microstepping
    [Allie.ini]
2016-03-14 Tweaks to X probe sub
2016-03-14 Invert PC PSU enable pin
    PSU no longer stays on when LinuxCNC isn't open.
    This change means all the logic isn't inverted within LinuxCNC.
    [Allie.hal]
2016-04-09 Added probe from right sub
2016-04-09 Limit switch and axis size tweaks
2016-04-13 HAL config change for inverted home switch
    [Allie.hal]
2016-04-24 Shorter X axis due to mist coolant
    [Allie.ini]
2016-04-24 Mist coolant on BoB pin 13
    Sw33t
    [Allie.hal]
2016-05-07 Longer Z axis travel, 0 at top
2016-06-26 Y probe feed tweaks
2016-07-22 Initial config for WJ200
    Currently only runs from a custom build branch as there is a segfault in the driver I had to fix.
    [Allie.hal, custom.hal, custom_postgui.hal]
2016-07-22 VFD PyVCP panel tweaks
    [custom_postgui.hal]
2016-07-23 Send spindle-at-speed signal to PyVCP
    [custom_postgui.hal]
2016-07-23 Fixed homing and overshoot errors
    - Y home now doesn't go to 0 after home
    - X and Y axes move 5mm off home switch locations when done
    [Allie.ini]
2016-07-23 LinuxCNC 2.8 config
    [Allie.hal]
2016-07-23 LinuxCNC 2.8 INI config
    - Lots of autoconversion shite
    - Fixes Z axis jogging when not homed. The joint must be allowed
    to travel beyond the axis limits. Weird.
    [Allie.ini]
2016-07-23 WJ200 talks over USB
    [custom.hal]
2016-07-23 Talk to WJ200 at 57600 baud
    [custom.hal]
2016-07-23 Awesome sidebar panel thing for WJ200
    [custom_postgui.hal]
2016-07-27 Combined Y home and limit switch
    Machine goes into ESTOP when limit is hit which is handy.
    [Allie.hal]
2016-07-27 X axis combined home and limit
    [Allie.hal]
2016-07-27 Home all axes with one button
    W00t! Z axis is still "move it to this position and software home"
    due to lack of limit switch. RIP.
2016-07-27 More obvious naming
    [Allie.hal]
2016-07-27 Unhome if machine power is turned off
    The steppers jump a bit when power is reapplied, so I really need
    to rehome them when that happens.
2016-07-27 Upped base period to squelch RTAI warning
    Seems to have been caused by removing the discrete GPU. Running
    glxgears spikes the realtime test, so presumably when LinuxCNC
    loads, the 3D view causes a massive latency spike, triggering the
    warning. Upping it to 15k ns and putting the discrete GPU back
    seems to have resolved the problem.
    [Allie.ini]
2016-07-27 Removed home/limit switches
    I'd get a limit error on X and Y as soon as I tried starting
    the spindle. Dunno why, so instead of investigating I'm just
    removing the limit inputs.
    [Allie.hal]
2016-07-29 New HAL configs for relay board
    - Invert an output as the relay board is active low
    - Add spindle pump pin, enabled when spindle is turning
    [Allie.hal]
2016-08-04 5mm shorter Y axis for new limit switch
    [Allie.ini]
2016-08-07 Y backlash comp at .015mm
    Dead nuts on backlash comp
    [Allie.ini]
2016-08-13 Don't force homing
2016-08-13 Correct default programs folder
    [Allie.ini]
2016-08-13 Correct servo/base period values
    [Allie.ini]
2016-08-26 Changed stepper scales to fix following err
    [Allie.ini]
2016-08-27 Tweaked FERROR settings, doesn't trip now
    [Allie.ini]
2016-09-04 Added config for Z limit switch
    awyeah.jpeg
    [Allie.hal]
2017-09-16 Add quadrature spindle encoder config
    Pins:
    BoB 11: Enc-A
    BoB 12: Enc-B
    BoB 13: Enc-Index
    [Allie.hal]
2017-09-23 WIP Mr Steely
    - Coolant (F7) wired to drawbar release. Requires 80 PSI pressure.
    Fucking awesome.
    - 3 motors wired in
    - PC and stepper PSU enable lines
    - No limit switches
    - No VFD yet
    - No spindle at speed
    [Allie.hal, custom.hal]
2017-09-28 Tweaked conf for new stepper driver
2017-10-07 Get spindle-at-speed working again
    [Allie.hal, custom_postgui.hal]
2017-10-09 Set XY limits and home switch
    [Allie.hal]
2017-10-14 Set spindle scale for servo/BT30 spindle
    [custom.hal]
2017-10-15 Speed up homing sequence
    This thing looks fricking awesome when it homes now
2017-10-15 Re-enable Z limit switch
    Should've committed this a while back!
    [Allie.hal]
2017-10-15 Max spindle speed display is 6k RPM
    The spindle can still be driven faster than this though, which isn't so
    great.
2017-10-23 Fix spindle at speed signal
    No longer shows in control panel but if it makes the machine wait I
    don't care.
    [Allie.hal, custom.hal, custom_postgui.hal]
2017-10-23 Slower X rapid to stop it binding
    [Allie.ini]
2017-10-23 Increase servo base period
    Let's see if this makes for a more reliable machine...
    [Allie.hal]
2017-10-28 Tweak accels and homing speeds
    Maybe this will stop the machine losing steps.
2017-10-28 Cleaner home switch config
    Still no fricking limit though
    [Allie.hal]
2017-10-28 Green light baby
    [custom_postgui.hal]
2017-11-03 Invert Y direction for new servo drives
    [Allie.hal]
2017-11-04 Tweak speeds and backlash for servos
    [Allie.ini]
2018-01-15 Add drawbar toggle button
    [custom.hal]
2018-01-16 Fix power/coolant enable pins
    Remove M8 flood; this was hijacked onto the drawbar command which is
    soopah dangerous. It's now got its own button and config in custom.hal.
    [Allie.hal]
2018-01-16 Change home switch input pins
    For the BBoB v1
    [Allie.hal]
2018-01-16 Remove commented out probe pin
    Probe input currently hijacked by drawbar engage button. Should probably
    fix this.
    [Allie.hal]
2018-03-02 Spindle multiplier for 50T spindle pulley
    [custom.hal]
2018-03-02 Set up quadrature encoder for rigid tapping
    [Allie.hal, custom.hal, custom_postgui.hal]
2018-03-02 Add spindle speeds spreadsheet thing
    Still tryna figure out this stuph
    [spindleSpeeds.xlsx]
2018-03-03 Add linear gradient measurement
    [spindleSpeeds.xlsx]
2018-03-03 Homing in on correct spindle scaling
    [custom.hal]
2018-03-03 Some update
    [spindleSpeeds.xlsx]
2018-03-03 Near perfect spindle scaling
    Thanks, spreadsheets
    [Allie.hal, custom.hal, spindleSpeeds.xlsx]
2018-03-03 Add debounce to drawbar button
    Will hopefully stop it being turned on by noise from the spindle.
    Previously, turning the spindle off from -6k RPM would cause the drawbar
    button to latch.
    [Allie.hal, custom.hal]
2018-03-03 Add spindle/drawbar interlock
    The fact that I have now been able to unironically use the word
    "interlock" is _way_ cool.
    [Allie.hal, custom.hal]
2019-11-05 Adjust backlash to measured values
    [Allie.ini]
2020-02-02 Increase Z axis limit for new gas spring
2020-02-02 Disable Z home switch
2020-02-20 Adjust Y limit for gas spring block
2020-02-20 Track version of LinuxCNC currently in use
2020-02-20 Add MPG jog pendant on secondary port
    [Allie.hal, mpg.hal]
2020-02-21 Auto upgrade to v2.9.0-pre0
    [Allie.hal, custom_gvcp.hal, custom_postgui.hal, mpg.hal, postgui_call_list.hal, shutdown.hal, spindle.hal]
2020-02-21 Fix MPG jogging after homing
    Unrelated to 2.9 upgrade
    [mpg.hal]
2020-02-23 Configure servo period from ini
    [Allie.hal]
2020-02-23 Fix PID/vel/acc values, no more f-error!
    [Allie.ini]
2020-02-23 Increase servo period a bit
2020-03-02 Reduce max following errors a bit
    [Allie.ini]
2020-03-02 Tweak max vel/acc with new motor tunage
2020-03-08 New breakout board initial commit
    [ATX_24pin.step, UnifiedBreakout.kicad_pcb, UnifiedBreakout.sch, breakout.kicad_pcb, breakout.sch, mesa_p3_back_panel.sch, motor_connector.sch]
2020-04-04 Simple spindle stepgen config
    [Allie.hal, _custom_gvcp.hal, _custom_postgui.hal, _postgui_call_list.hal, spindle.hal, spindle_postgui.hal, wj200.hal]
2020-04-05 Spindle orient wiring
    [Allie.hal, spindle.hal]
2020-04-05 Make spindle speed comp a bit less nasty
2020-04-05 fixup! Spindle orient wiring
    [spindle.hal]
2020-04-11 Unified breakout schematic "done"
    [UnifiedBreakout.kicad_pcb, UnifiedBreakout.sch, argon_encoder.sch, argon_estop.sch, argon_io.sch, jog_pendant.sch, mesa_prob_rfx2_p2_internal.sch, mesa_prob_rfx2_p3_rear.sch]
2020-04-12 Invert outputs for active low, other cleanup
    [UnifiedBreakout.kicad_pcb, UnifiedBreakout.sch, argon_encoder.sch, argon_estop.sch, argon_io.sch, jog_pendant.sch, mesa_prob_rfx2_p2_internal.sch, mesa_prob_rfx2_p3_rear.sch]
2020-04-12 Add extra pullups on inputs
    [UnifiedBreakout.kicad_pcb, UnifiedBreakout.sch, opto_input.sch]
2020-04-12 Connectors placed
    [UnifiedBreakout.kicad_pcb, UnifiedBreakout.sch, argon_encoder.sch, mesa_prob_rfx2_p2_internal.sch, mesa_prob_rfx2_p3_rear.sch, motor_connector.sch, opto_input.sch]
2020-04-13 Did some more layout
    [UnifiedBreakout.kicad_pcb]
2020-04-14 More placement, add some custom parts
    [RAPC722BK.stl, RAPC722BK.stp, UnifiedBreakout.kicad_pcb, UnifiedBreakout.sch, argon_encoder.sch, argon_estop.sch, motor_connector.sch, opto_input.sch]
2020-04-16 Assigned some parts
    [UnifiedBreakout.kicad_pcb, UnifiedBreakout.sch, argon_estop.sch, motor_connector.sch, opto_input.sch, relay.sch]
2020-04-18 Finished(?) unified breakout layout
    [UnifiedBreakout.kicad_pcb, UnifiedBreakout.sch, argon_encoder.sch, motor_connector.sch, opto_input.sch, relay.sch]
2020-04-19 Updated BOM
    [UnifiedBreakout-bom.csv, UnifiedBreakout.kicad_pcb, UnifiedBreakout.sch, argon_io.sch, jog_pendant.sch, mesa_prob_rfx2_p2_internal.sch, mesa_prob_rfx2_p3_rear.sch, motor_connector.sch]
2020-04-28 Final updates to unified BoB
    [UnifiedBreakout-bom.csv, UnifiedBreakout.kicad_pcb, UnifiedBreakout.sch, argon_io.sch, motor_connector.sch, opto_input.sch, relay.sch]
2020-04-28 Generate gerbers
    [UnifiedBreakout-B_Cu.gbr, UnifiedBreakout-B_Mask.gbr, UnifiedBreakout-B_SilkS.gbr, UnifiedBreakout-Edge_Cuts.gbr, UnifiedBreakout-F_Cu.gbr, UnifiedBreakout-F_Mask.gbr, UnifiedBreakout-F_SilkS.gbr, UnifiedBreakout.drl]
2020-05-11 WIP unified breakout config
    [Allie.hal, mpg.hal, spindle.hal]
2020-05-13 WIP more unified breakout config
    [Allie.hal, spindle.hal]
2020-05-16 Reenable spindle PWM (velocity mode) config
    [Allie.hal, spindle.hal]
2020-05-23 Correct NC/NO for limit switches
    [Allie.hal]
2020-05-24 Tweak spindle PWM scale
    [spindle.hal]
2020-08-10 PWM Argon spindle
    [spindle.hal]
2020-09-15 Add PCB photos and beginnings of overlay
2020-09-22 Add Indramat resolver reverse engineering shit
    [IndramatResolver.kicad_pcb, IndramatResolver.sch]
2020-09-22 Spindle orient without PID
    [spindle.hal]
2020-11-15 Add Argon spindle config
    [_custom_gvcp.hal, _custom_postgui.hal, _postgui_call_list.hal, custompanel.hal, shutdown.hal, spindle.hal, spindle_postgui.hal]
2020-12-01 Final fixes for Argon Rust control
    [spindle.hal]
2021-01-31 Fix servo noise
2021-03-13 Improve X backlash after ballnut rebuild from 0.10 to 0.02
    [Allie.ini]
2021-03-13 Reduce Z backlash from 0.08 to 0.02 from measurements
    [Allie.ini]
2021-03-28 Update big breakout board to Kicad nightly
    [UnifiedBreakout.kicad_pcb, UnifiedBreakout.kicad_sch, argon_encoder.kicad_sch, argon_estop.kicad_sch, argon_io.kicad_sch, jog_pendant.kicad_sch, mesa_prob_rfx2_p2_internal.kicad_sch, mesa_prob_rfx2_p3_rear.kicad_sch]
2021-03-28 Fix spindle synchronised motion
    [spindle.hal]
2021-04-17 Add M3 tap drill and tap tools
2021-06-21 Tweak backlash
2021-06-21 Probe HAL config
    [probe.hal]
2021-06-21 Add T98 electronic probe
2021-07-14 Update backlash using 0.002mm indicator
    [Allie.ini]
2022-05-03 Upgrade to new KiCAD version
    [UnifiedBreakout.kicad_pcb, UnifiedBreakout.kicad_sch, argon_encoder.kicad_sch, argon_estop.kicad_sch, argon_io.kicad_sch, jog_pendant.kicad_sch, mesa_prob_rfx2_p2_internal.kicad_sch, mesa_prob_rfx2_p3_rear.kicad_sch]
2022-05-28 Modify Z home for inductive limit switch
    [Allie.hal]
2022-05-28 Reduce drawbar button debounce
    [Allie.hal]
2022-06-04 Use proximity switch for Y home
    [Allie.hal]
2022-06-04 Reinstate Z home switch
    After how many years lmao?
2022-06-24 Show probe status in panel
    [custompanel.hal]
2022-06-24 Set up X, Y and Z back left corner probing routines
    [probe-calibration.xlsx]
2022-09-16 Drive fault LED in UI
    [custompanel.hal, spindle.hal]
2022-09-19 Spindle balancing notes
2023-03-15 WIP updating breakout for electrical enclosure
    [UnifiedBreakout.kicad_pcb, UnifiedBreakout.kicad_sch, argon_encoder.kicad_sch, argon_estop.kicad_sch, argon_io.kicad_sch, jog_pendant.kicad_sch, mesa_prob_rfx2_p2_internal.kicad_sch, mesa_prob_rfx2_p3_rear.kicad_sch]
2023-03-16 Add stacked DA15 part
    [NorComp-Dual-DA15.stp, UnifiedBreakout.kicad_pcb, UnifiedBreakout.kicad_sch, argon_encoder.kicad_sch, argon_estop.kicad_sch, jog_pendant.kicad_sch]
2023-03-16 Add dual level DB25
    [NorComp-178-Dual-DA15.stp, NorComp-178-Dual-DB25.stp, UnifiedBreakout.kicad_pcb, argon_io.kicad_sch, mesa_prob_rfx2_p2_internal.kicad_sch, mesa_prob_rfx2_p3_rear.kicad_sch]
2023-03-16 Grouped 4 way RJ45s
    [UnifiedBreakout.kicad_pcb, argon_estop.kicad_sch, motor_connector.kicad_sch]
2023-03-22 Update IO and opto
    [UnifiedBreakout.kicad_pcb, UnifiedBreakout.kicad_sch, argon_encoder.kicad_sch, argon_estop.kicad_sch, argon_io.kicad_sch, jog_pendant.kicad_sch, mesa_prob_rfx2_p2_internal.kicad_sch, mesa_prob_rfx2_p3_rear.kicad_sch]
2023-03-22 Tweaks and stuff
    [UnifiedBreakout.kicad_pcb, UnifiedBreakout.kicad_sch]
2023-03-22 Started some layout
    [UnifiedBreakout.kicad_pcb, UnifiedBreakout.kicad_sch, argon_encoder.kicad_sch, argon_estop.kicad_sch, argon_io.kicad_sch, jog_pendant.kicad_sch, mesa_prob_rfx2_p2_internal.kicad_sch, motor_connector.kicad_sch]
2023-03-23 Some layout
    [UnifiedBreakout.kicad_pcb, UnifiedBreakout.kicad_sch, argon_encoder.kicad_sch, argon_estop.kicad_sch, argon_io.kicad_sch, jog_pendant.kicad_sch, mesa_prob_rfx2_p2_internal.kicad_sch, mesa_prob_rfx2_p3_rear.kicad_sch]
2023-03-23 Couple of routes
    [UnifiedBreakout.kicad_pcb]
2023-03-24 Final tweaks for production
    [UnifiedBreakout.kicad_pcb, UnifiedBreakout.kicad_sch, argon_estop.kicad_sch, argon_io.kicad_sch, bom.csv, designators.csv, jog_pendant.kicad_sch, opto_input.kicad_sch]
2023-03-26 V3 BOM
    [UnifiedBreakout-bom.csv, UnifiedBreakout.csv, UnifiedBreakout.kicad_sch, opto_input.kicad_sch]
2023-04-08 Use 2k2 resistor for 24V power LED
    [UnifiedBreakout.kicad_sch]
2023-04-08 Fix dual DB25 pin ordering
2023-04-19 Drawbar button interlock when spindle is on
    [Allie.hal, spindle.hal]
2023-04-19 Reset backlash
2023-07-09 Fix subs path, start tracking saved vars
    [Allie.ini]
2023-07-09 Set tool lengths for 5.5 drill and chamfer mill
2023-07-09 Make probe subs callable
2023-07-10 Add some tool probe SOPs
2023-07-14 Reset backlash ready for remeasurement
    [Allie.ini]
2023-07-15 Fix Z tool change errors, gcode path
    [Allie.ini]
2023-07-15 Add 4.2mm tap drill
2023-07-17 Add Samba mount instructions
2023-08-19 Add 5mm drill
2023-08-19 Separate toolsetter input
    [Allie.hal, probe.hal]
2023-08-19 Set length of 5mm jobber drill
2023-08-19 A bunch of probe fettling
2023-08-20 Save/restore original WCS after probe
2023-08-20 Add M5 tap, retouch a couple of tools
2023-08-20 Add Y neg probe sub
2023-10-18 Add 6.5 drill and 10mm long length HSS
2023-10-27 Add T13: 8mm-4fl-rougher-hss-tialn-060-283-06008
2023-10-30 Add 8.5mm jobber drill T14
2023-11-02 Migrate tool library from CAD repo
    [ballend.fcstd, bullnose.fcstd, chamfer.fcstd, drill.fcstd, endmill.fcstd, probe.fcstd, slittingsaw.fcstd, spot-drill.fcstd]
2023-11-09 Add 3.3mm drill
2023-11-10 Copy working X axis config over
    [cia402.hal, shutdown.hal]
2023-11-19 Reduce X accel
    It was erroring out after greasing the ballnut for some reason.
    [Allie.ini]
2023-12-11 Make EC400 work in CSV mode
    [cia402.hal]
2023-12-11 Report actual torque
    Not currently used but nice to have
2023-12-11 Coupla tweaks
    [cia402.hal]
2023-12-13 Correctly scale axis for 10mm lead screw
    [cia402.hal]
2023-12-13 PID loop setup
    [cia402.hal]
2023-12-13 Torque mode notes
2023-12-13 Go back to CSP
    [cia402.hal]
2023-12-13 Reasonable values for X and Y
    [cia402.hal]
2023-12-13 Z axis servo config
    [cia402.hal]
2023-12-13 Tweak velocity/accel settings
2023-12-16 Giving up on homing for now
    [cia402.hal]
2023-12-17 INI config that at least sets homing pin high
2023-12-17 Expose Z index pin to LinuxCNC
2023-12-17 Use LCNC internal homing routines
    [cia402.hal]
2023-12-17 Homing WIP
2023-12-18 Set all limit switches and limits
    [cia402.hal]
2023-12-18 Add DB button to X axis DI2
2023-12-18 Reinstate Argon spindle
    No orient yet though
    [cia402.hal, custompanel.hal, spindle.hal]
2023-12-18 Get rid of 5i25 spindle encoder config
    Spindle still works yay
    [spindle.hal]
2023-12-18 Drawbar button interlock
    [cia402.hal, spindle.hal]
2023-12-18 TODO sigh
    [spindle.hal]
2023-12-18 Make toolchange work again
    [cia402.hal]
2023-12-19 New version of Argon driver
    [spindle.hal]
2023-12-22 Updates and stuff
    [custompanel.hal, spindle.hal]
2024-03-16 Fails on SM watchdog
    [argon-spindle.hal, cia402.hal]
2024-03-17 AKD doesn't sit in error state any more
    Hooray... still doesn't work though
    [akd-spindle.hal, cia402.hal]
2024-03-17 Brake control note
2024-03-17 Working basic velocity mode AKD!
2024-03-17 Add reamer and threadmill tools
2024-03-18 Half working AKD spindle motor
    [akd-spindle.hal, cia402.hal]
2024-03-18 Spindle at speed working
    [akd-spindle.hal]
2024-03-19 Hook up spindle drive fault to UI
    [akd-spindle.hal, custompanel.hal]
2024-03-19 Configure external AKD braking resistor
2024-03-19 Reverse spindle direction
2024-03-19 150W AKD brake resistor
2024-03-19 Report actual spindle position
2024-03-19 Get spindle position into `spindle` component
    [akd-spindle.hal]
2024-03-19 Get rid of encoder stuff
2024-03-20 Reorder EtherCAT devices to put AKD in cabinet
    [akd-spindle.hal, cia402.hal]
2024-03-20 Add 5mm 3fl APT carbide for aluminium tool
2024-03-20 Some notes on e1000e driver
2024-03-22 Add toolsetter input
    [cia402.hal, custompanel.hal]
2024-03-22 Set up touch probe input
    [cia402.hal, custompanel.hal]
2024-03-22 Re-touch-off probe and toolsetter
2024-03-23 Touch off fixture plate test tools
2024-03-25 Use drives in CSV mode
    This is an attempt to mitigate weird stuttering
    [cia402.hal]
2024-04-01 Go back to CSP, use 4ms cycle time
    - CSP gives much more accurate and more stiff axes
    - 4ms cycle time mitigates the horrible banging from before
    [cia402.hal]
2024-04-01 Add sub to probe oversize tools
2024-04-01 Fix/add axis probe routines
2024-04-02 WIP probe rect subroutine
2024-04-02 Probe X part
2024-04-02 Snazzy boss probe subroutine
2024-04-02 Bottom left corner probe
2024-04-03 Add 5.9mm carbide drill
2024-04-05 Add 6.8 tap drill in chuck
2024-04-30 Config fuckery
    [cia402.hal]
2024-05-05 Embassy skeleton for STM32F411 black pill
2024-05-05 Move to STM32F103
2024-05-05 Dual encoders
2024-05-05 Respond to encoder key inputs
2024-05-06 4ms EtherCAT cycle to fix shitty jitter
    [cia402.ini]
2024-05-06 Tweak initial velocity
2024-05-07 Integrate into LinuxCNC
    [module.hal]
2024-05-07 More LinuxCNC hookage
    [module.hal]
2024-05-07 Feed override knob works!
    [module.hal]
2024-05-07 Feed override reset works now too
    [module.hal]
2024-05-07 Rapid override and reset
    [module.hal]
2024-05-07 Change pins for final prototype hardware
2024-05-07 Move everything into machine config
    [control-box.hal]
2024-05-07 Update control box config for actual machine
    [control-box.hal]
2024-05-20 Wire up flood coolant to mist pressurise
    [cia402.hal]
2024-05-20 Better backlash without shitty indicator stand
    [cia402.ini]
2024-05-21 Add 2mm ball endmill
2024-05-21 New offset for 2mm ball
2024-05-25 New tools, touch off probe again
2024-05-25 Slow down tool probe for better consistency
    Better, but not perfect :(
2024-05-25 Another go at balancing the spindle
    [spindle-motor-only-vibes.csv, spindle-vibes.csv]
2024-05-26 Add T29: 2mm 3fl ballnose for alu
2024-05-27 Add lowpass filter gain calculator
    [lowpass-calc.ods]
2024-05-27 Disable spindle if DB is engaged, use round gauge for spindle RPM
    [akd-spindle.hal, custompanel.hal]
2024-06-03 Start control box PCB design
    [5032_4P.STEP, 67503-1020.stp, 675031020.psm, EDI2CAP.CFG, PEC11L-4115F-S0020.stp, TS-1187A-B-A-B.stp, chips.prt, cnc-interface-panel.kicad_pcb]
2024-06-13 Probe is in fact ok
2024-06-13 Add probe X-only boss subroutine
2024-06-13 Touch off 6.3 spot drill and 6.5 drill
2024-10-12 Start control box PCB
    [cnc-interface-panel.kicad_pcb]
2024-10-13 Finish laying out CNC encoders PCB
    [cnc-interface-panel.kicad_pcb, cnc-interface-panel.kicad_sch]
2024-12-03 Update control box firmware for custom PCB
2024-12-03 Ignore more KiCAD stuff
2024-12-03 Reinstate control box after custom PCB
2024-12-03 Reverse control box encoder direction
    [main.rs]
2024-12-03 Fix control box PCB issues, add USB connector to BOM
    [cnc-interface-panel.kicad_pcb, cnc-interface-panel.kicad_sch]
2025-01-19 Add spindle ring light control
    [cia402.hal, custompanel.hal]
