jamwaffles/CNCMachine/IndramatResolver/PCB/20200531_094003309_iOS.jpg

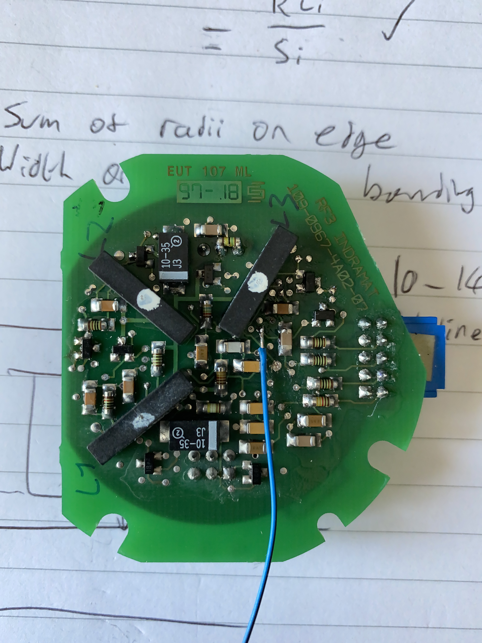
IndramatResolver/PCB/20200531_094003309_iOS.jpg
